RyanBilock/EMCH-308_Group-6_Final-Project/cad/concept_drawings/Hole_Layout_Stock1_Drilled_v2.png

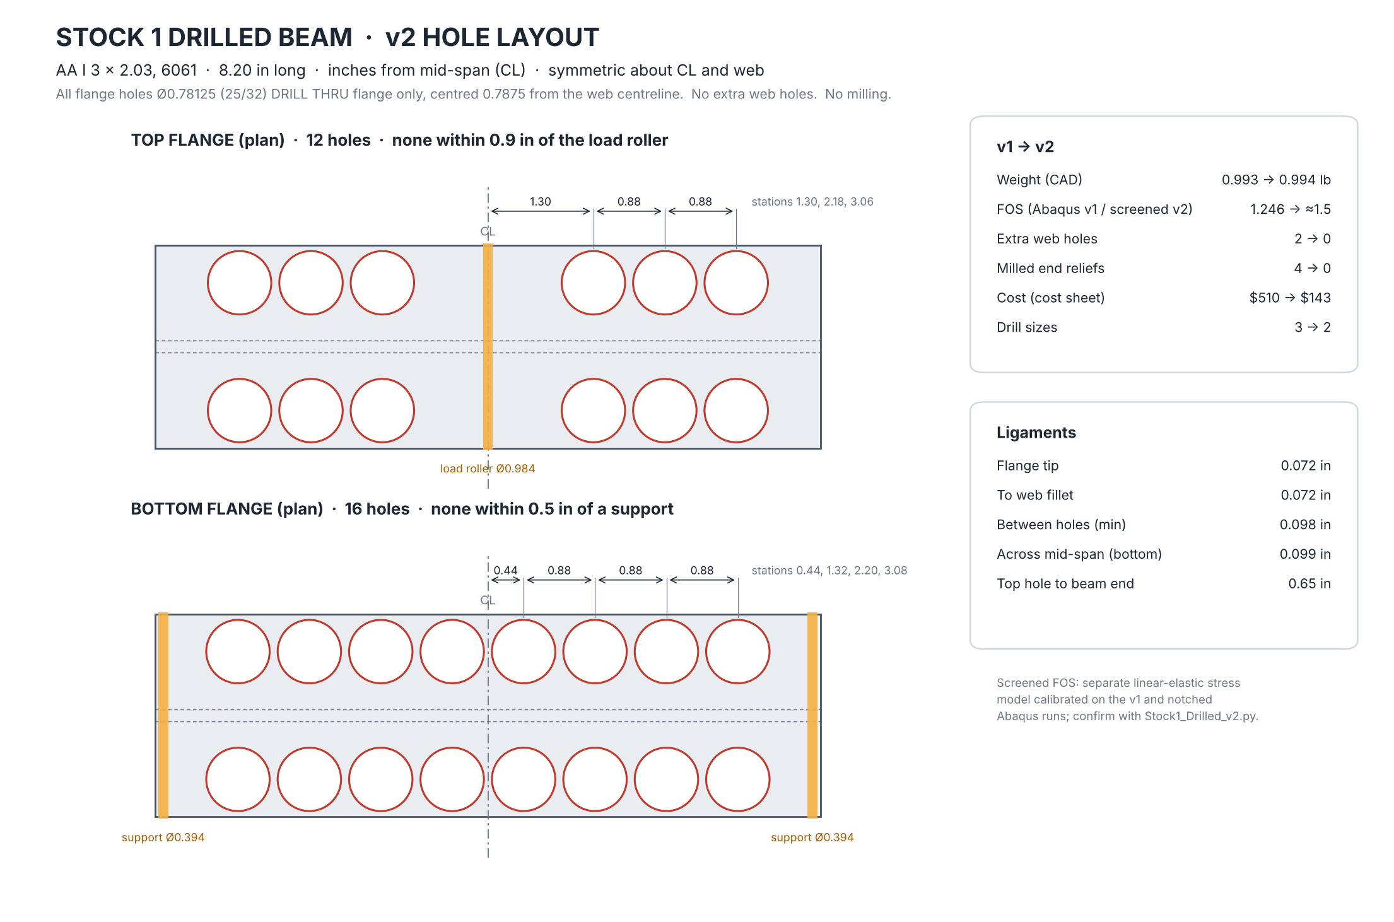
cad/concept_drawings/Hole_Layout_Stock1_Drilled_v2.png
