RyanBilock/EMCH-308_Group-6_Final-Project/cad/USC06_MTC06_IBeam_RevC_Drawing_sheet2.png

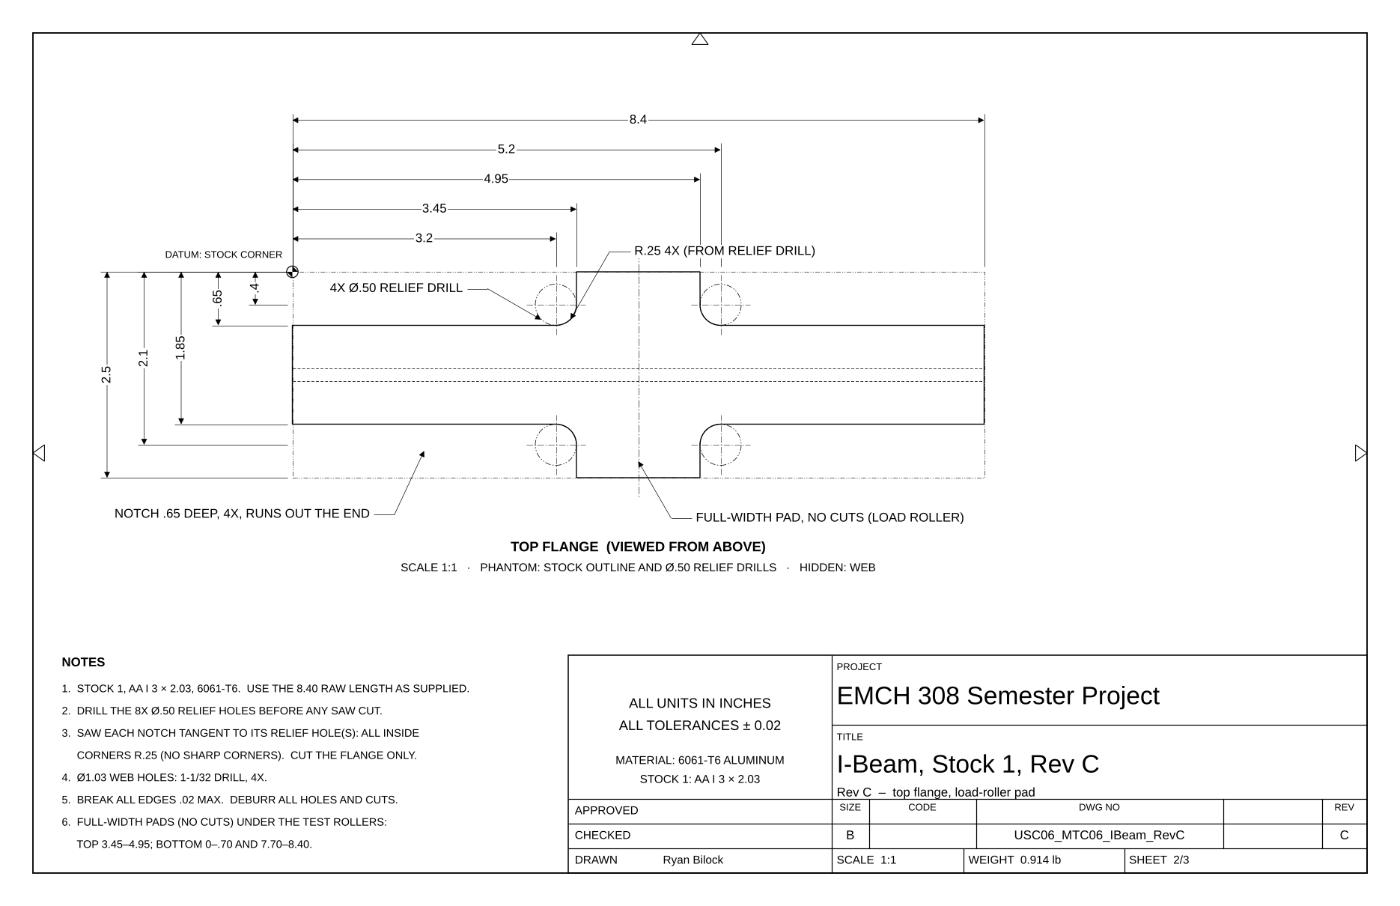
cad/USC06_MTC06_IBeam_RevC_Drawing_sheet2.png
