RyanBilock/EMCH-308_Group-6_Final-Project/Final_Design/Drawings/Design_Sheet_Stock1_Drilled_v2.png

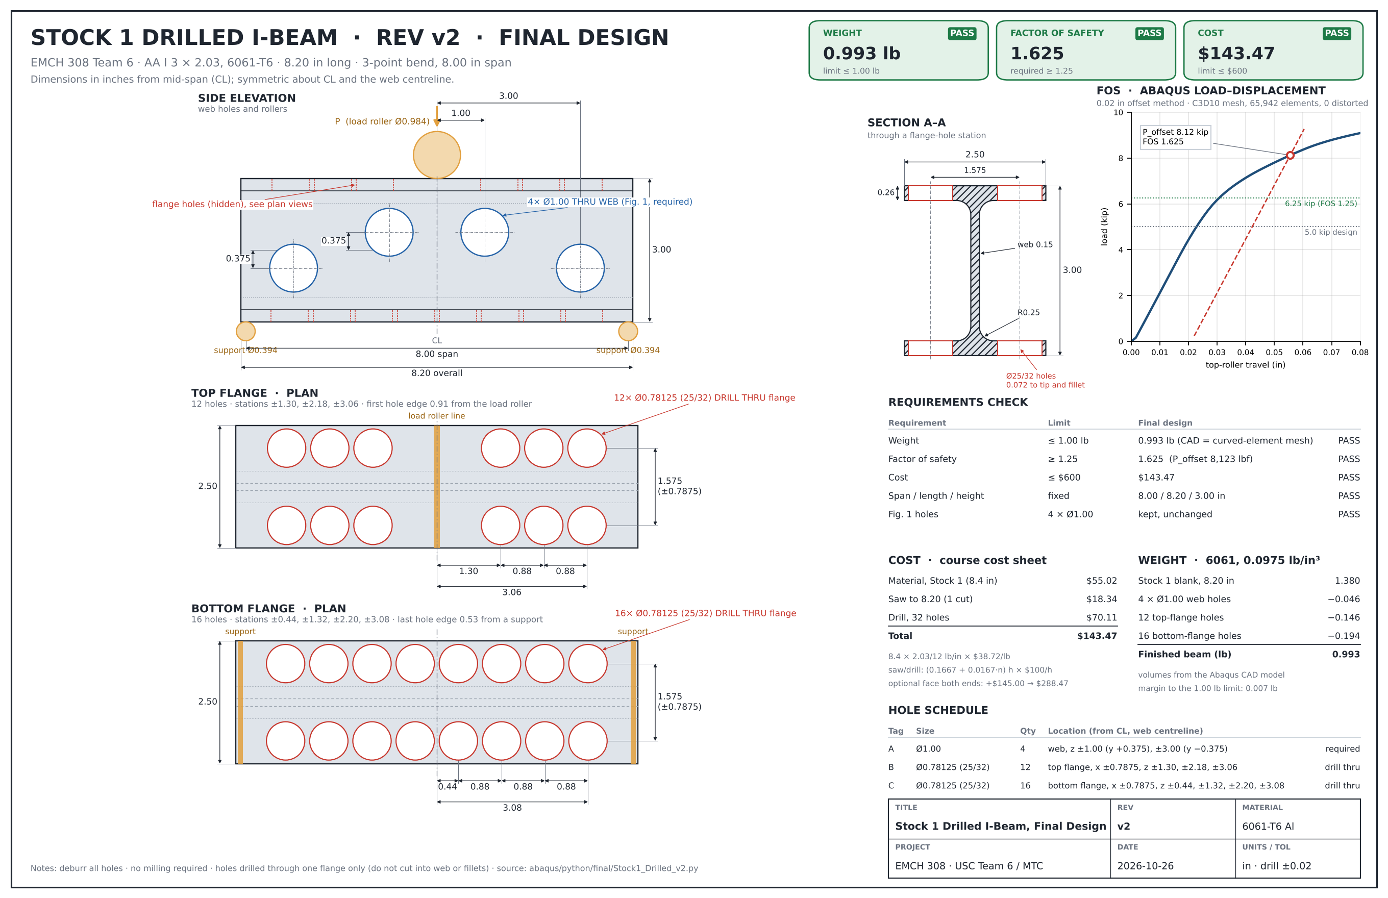
Final_Design/Drawings/Design_Sheet_Stock1_Drilled_v2.png
