RyanBilock/EMCH-308_Group-6_Final-Project/Final_Design/Drawings/Proposal_RevC_Stock1_v2.png

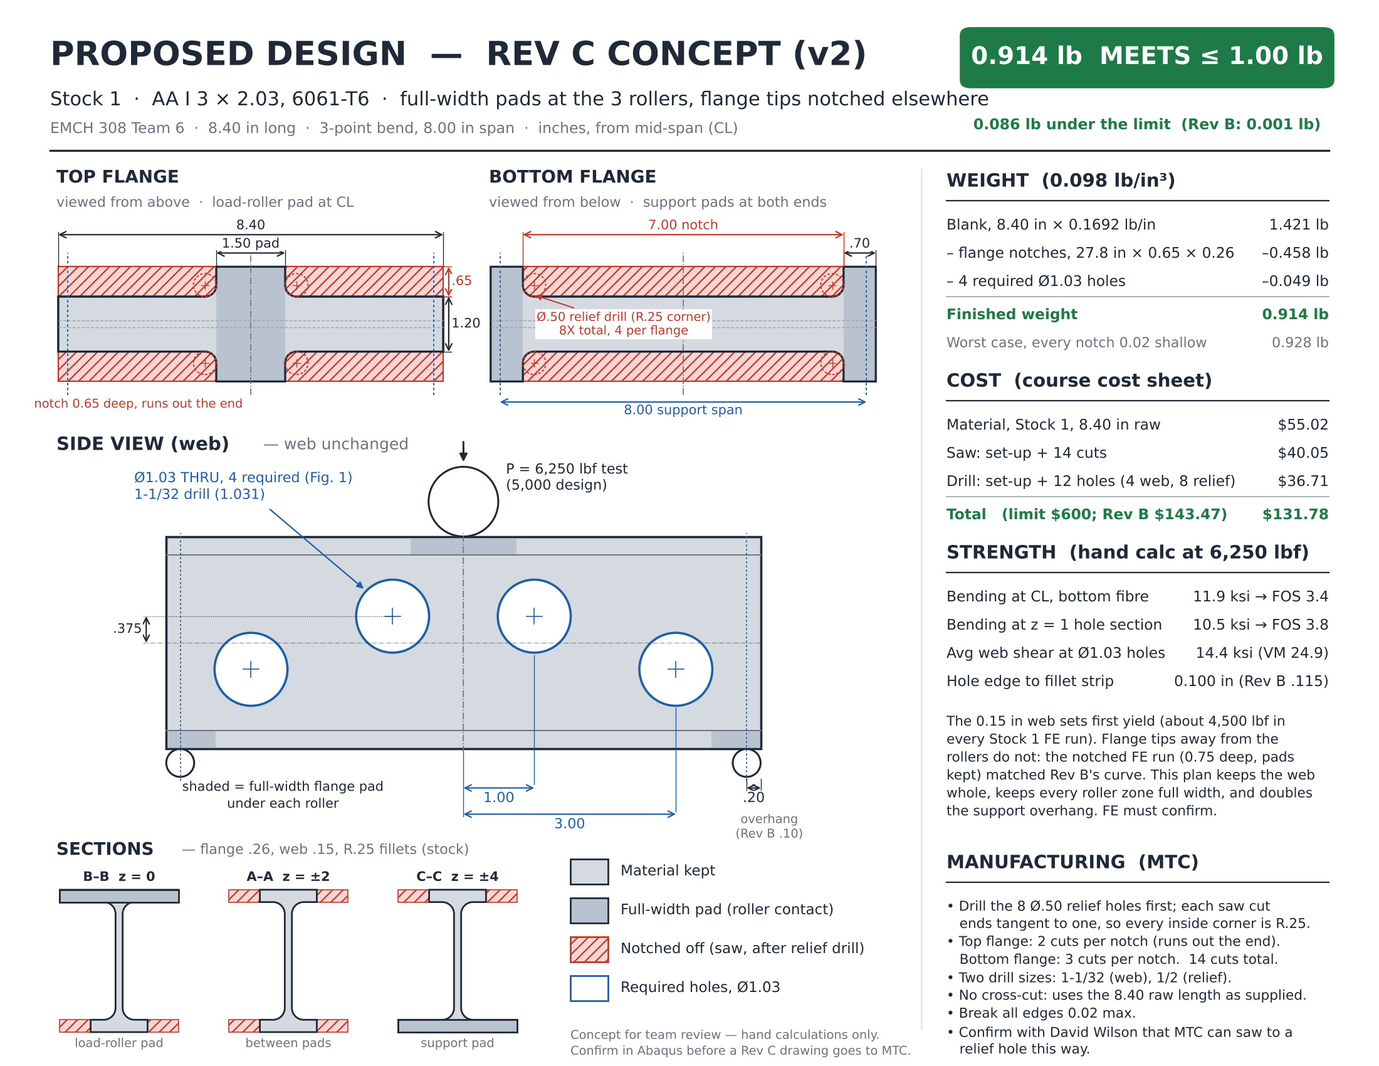
Final_Design/Drawings/Proposal_RevC_Stock1_v2.png
