RyanBilock/EMCH-308_Group-6_Final-Project/Final_Design/Drawings/USC06_MTC06_IBeam_RevC_Drawing_sheet1.png

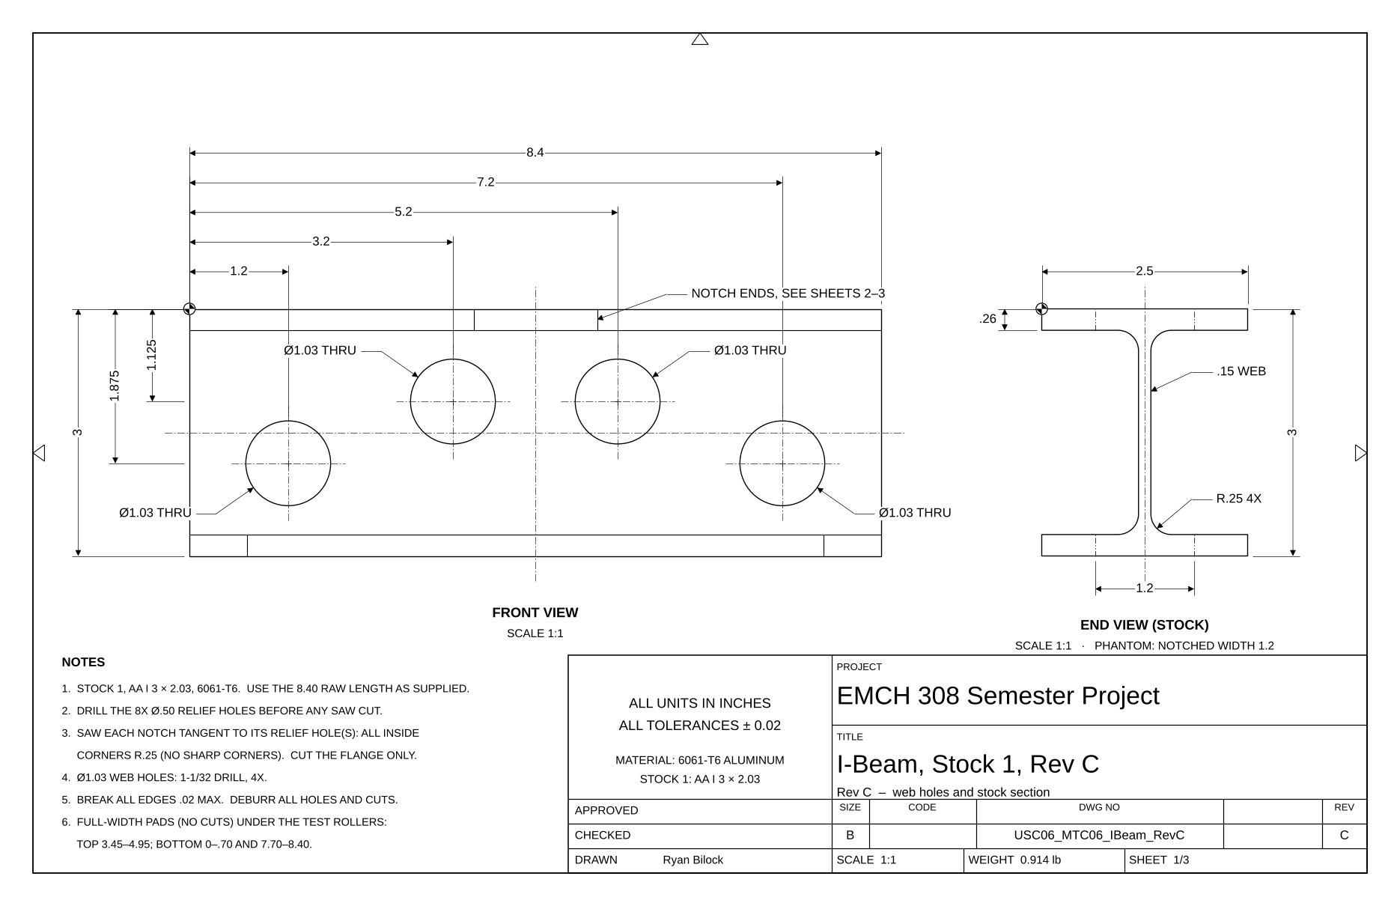
Final_Design/Drawings/USC06_MTC06_IBeam_RevC_Drawing_sheet1.png
