RyanBilock/EMCH-308_Group-6_Final-Project/results/final_design/Stock1_Drilled_v2_LoadDisp.png

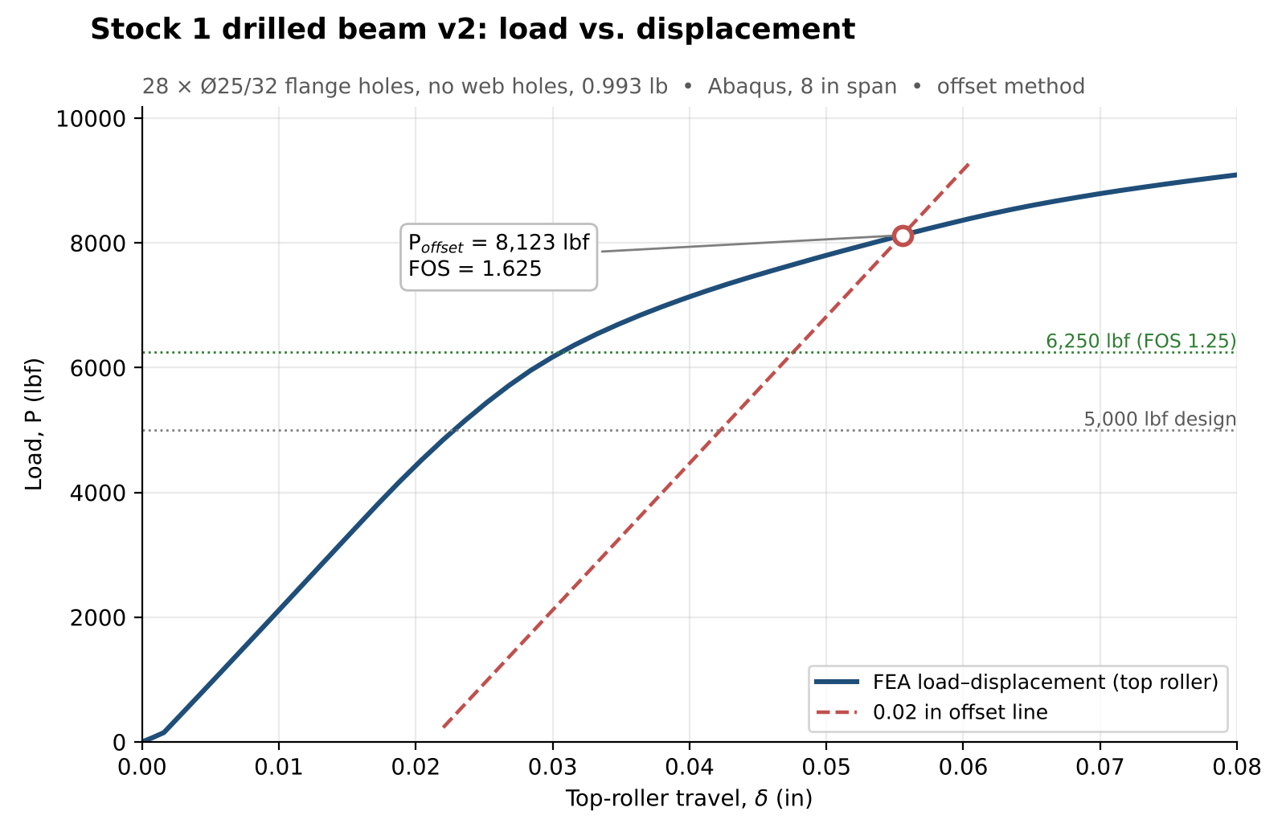
results/final_design/Stock1_Drilled_v2_LoadDisp.png
