RyanBilock/EMCH-308_Group-6_Final-Project/cost/ProjectCostSheet_RevC_Stock1_v2.xlsx

Sheet: Machining Cost
I-Beam Structure Analysis Project Cost
Stock Selection | Stock 1
Material Cost (per lb.) | $38.72
Raw Material Length (in) | 8.4
Weight (lb./in) | 0.1691666667
Material Cost Per Pc. | $55.02
Work Center Cost Including Overhead |  | Saw Cut | Saw Cut Miter | Drill | Face Ends | Mill
Tolerance (+/- inches) |  | 0.02 | 0.02 | 0.02 | 0.005 | 0.005
(2 x Labor + Material + Overhead) |  | $100.00 | $100.00 | $100.00 | $250.00 | $250.00
Set Up Time |  | 0.1667 | 0.1667 | 0.1667 | 0.5 | 0.5
Cycle Time Per Feature |  | 0.2338 | 0 | 0.2004 | 0 | 0
Cycle Time Basis |  | Per cut | Per cut | Per hole | Per end | Per inch of tool path with 0.05" removed for each pass
Qty Features |  | 14 | 0 | 12 | 0 | 0
Qty Parts |  | 1 | 1 | 1 | 1 | 1
Machine Time Cost |  | $40.05 | $0.00 | $36.71 | $0.00 | $0.00
Work Center Cost + Overhead + Machine Time | $131.78

Sheet: Stock Info
 | Stock 1 (https://www.onlinemetals.com/en/buy/aluminum/3-x-2-5-x-0-15-aluminum-i-beam-6061-t6-extruded-aluminum-association/pid/13207) | Stock 2 (https://www.onlinemetals.com/en/buy/aluminum/3-x-2-33-x-0-17-aluminum-i-beam-6061-t6-extruded-american-standard/pid/13216) | Stock 3 (https://www.onlinemetals.com/en/buy/aluminum/3-x-2-509-x-0-349-aluminum-i-beam-6061-t6-extruded-american-standard/pid/13217)
Height (in) | 3 | 3 | 3
Flange Width (in) | 2.5 | 2.33 | 2.509
Flange Thickness (in) | 0.26 | 0.17 | 0.17
Web Thickness (in) | 0.15 | 0.17 | 0.349
Material Cost (per lb.) | $38.72 | $26.78 | $39.36
Raw Material Length (in) | 8.4 | 8.4 | 8.4
Weight (lb./in) | 0.1691666667 | 0.1641666667 | 0.2166666667
Material Cost Per Pc. | $55.02 | $36.93 | $71.64
