RyanBilock/EMCH-308_Group-6_Final-Project/cad/concept_drawings/Cost_Plan_Stock1_v2.png

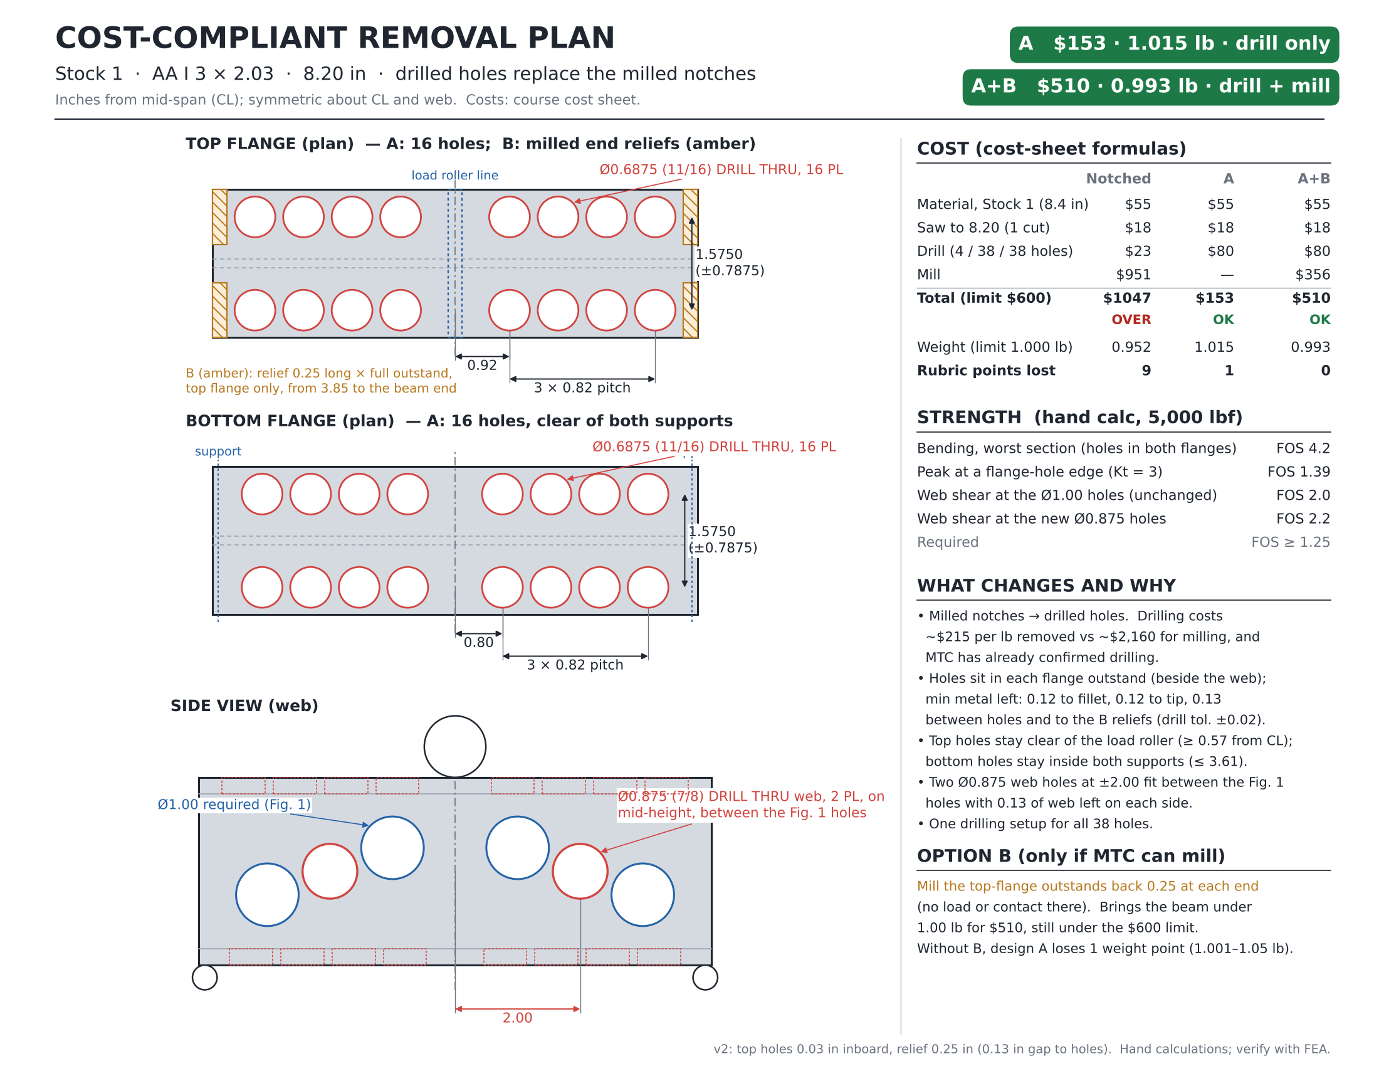
cad/concept_drawings/Cost_Plan_Stock1_v2.png
