RyanBilock/EMCH-308_Group-6_Final-Project/cad/concept_drawings/Material_Removal_Stock1_v1.png

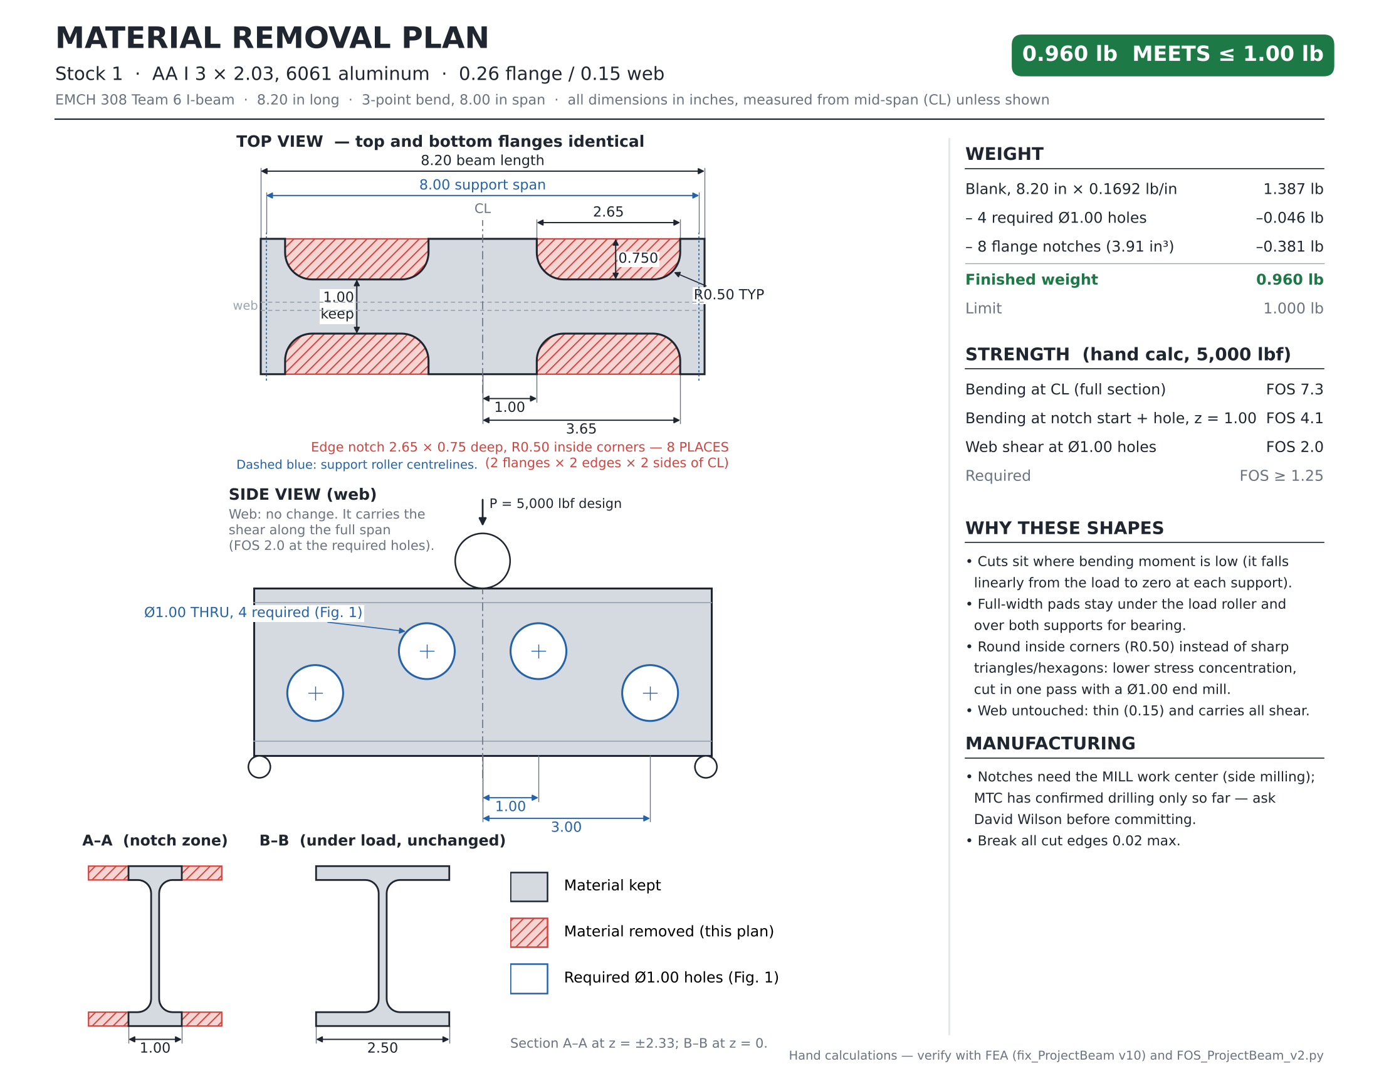
cad/concept_drawings/Material_Removal_Stock1_v1.png
