RyanBilock/EMCH-308_Group-6_Final-Project/cad/USC06_MTC06_IBeam_RevB.step

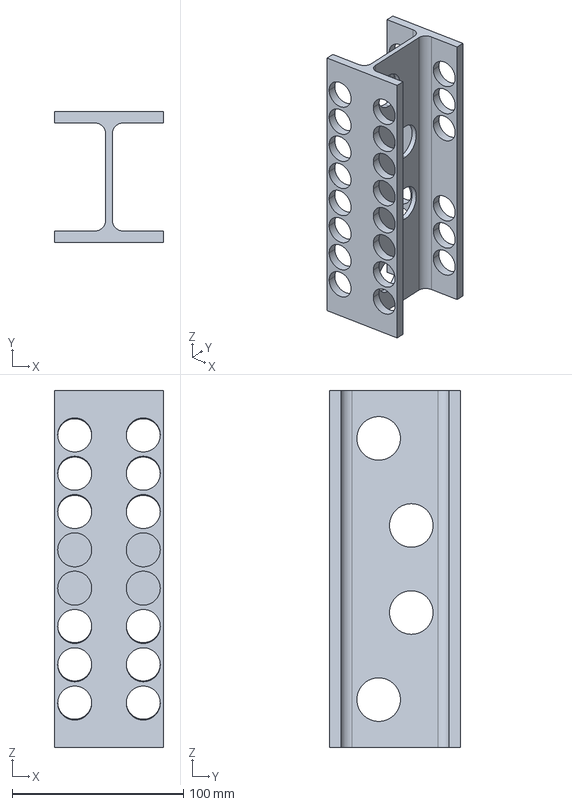
[picture p20: CAD file, 2026-10-26]
cad/USC06_MTC06_IBeam_RevB.step
63.5 x 76.2 x 208.3 mm
