RyanBilock/EMCH-308_Group-6_Final-Project/Final_Design/CAD/USC06_MTC06_IBeam_RevC.step

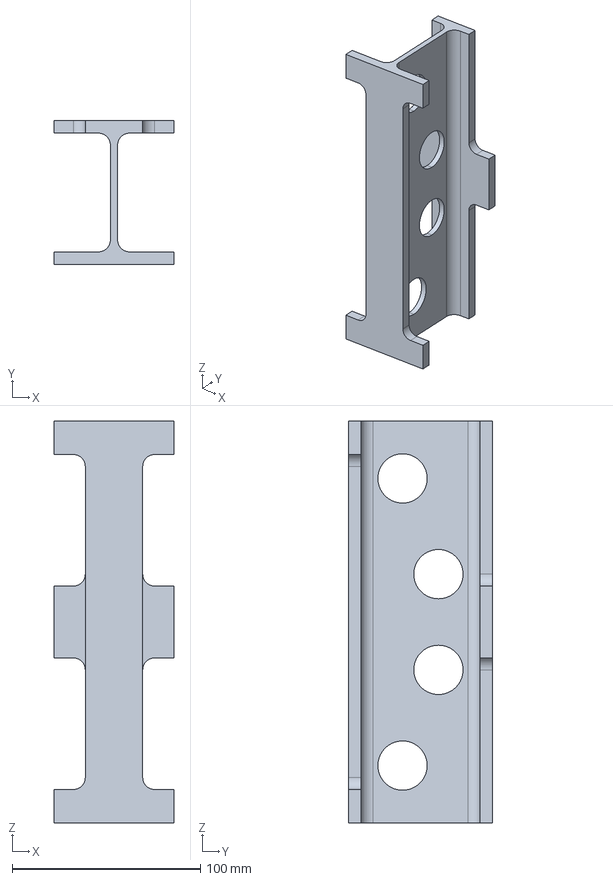
[picture p21: CAD file, 2026-11-03]
Final_Design/CAD/USC06_MTC06_IBeam_RevC.step
63.5 x 76.2 x 213.4 mm
