RyanBilock/EMCH-308_Group-6_Final-Project/Final_Design/Results/FOS_Stock1_RevC_v2_LoadDisp.csv

travel_in | load_lbf | offset_line_lbf
0.000000 | 0.00 | 0.00
0.000080 | 20.25 | 0.00
0.000160 | 40.42 | 0.00
0.000280 | 70.73 | 0.00
0.000460 | 116.19 | 0.00
0.000730 | 184.38 | 0.00
0.001135 | 286.66 | 0.00
0.001742 | 440.05 | 0.00
0.002542 | 642.00 | 0.00
0.003342 | 843.91 | 0.00
0.004142 | 1045.77 | 0.00
0.004943 | 1247.59 | 0.00
0.005743 | 1449.35 | 0.00
0.006543 | 1651.07 | 0.00
0.007343 | 1852.75 | 0.00
0.008143 | 2054.37 | 0.00
0.008942 | 2255.95 | 0.00
0.009743 | 2457.49 | 0.00
0.010542 | 2658.92 | 0.00
0.011343 | 2860.16 | 0.00
0.012142 | 3061.18 | 0.00
0.012943 | 3261.92 | 0.00
0.013742 | 3462.22 | 0.00
0.014542 | 3662.04 | 0.00
0.015343 | 3861.46 | 0.00
0.016143 | 4060.37 | 0.00
0.016942 | 4258.71 | 0.00
0.017742 | 4456.40 | 0.00
0.018543 | 4652.99 | 0.00
0.019343 | 4847.56 | 0.00
0.020142 | 5039.25 | 46.59
0.020942 | 5227.46 | 247.40
0.021743 | 5411.50 | 448.20
0.022543 | 5590.75 | 649.01
0.023342 | 5763.84 | 849.81
0.024143 | 5929.62 | 1050.62
0.024943 | 6088.64 | 1251.42
0.025742 | 6240.76 | 1452.23
0.026542 | 6385.97 | 1653.03
0.027343 | 6524.51 | 1853.84
0.028143 | 6656.54 | 2054.64
0.028942 | 6781.22 | 2255.45
0.029742 | 6897.63 | 2456.25
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
