RyanBilock/EMCH-308_Group-6_Final-Project/results/iterations/Stock1_Drilled_v1/FOS_Stock1_Drilled_LoadDisp.csv

travel_in | load_lbf | offset_line_lbf
0.000000 | 0.00 | 0.00
0.000800 | 69.04 | 0.00
0.001600 | 80.63 | 0.00
0.002800 | 295.82 | 0.00
0.004400 | 594.12 | 0.00
0.006000 | 892.87 | 0.00
0.007600 | 1191.99 | 0.00
0.008000 | 1266.80 | 0.00
0.009600 | 1566.08 | 0.00
0.011200 | 1865.37 | 0.00
0.012800 | 2164.34 | 0.00
0.014400 | 2459.85 | 0.00
0.016000 | 2749.47 | 0.00
0.017600 | 3032.59 | 0.00
0.019200 | 3305.53 | 0.00
0.020800 | 3564.99 | 0.00
0.022400 | 3807.80 | 236.35
0.024000 | 4035.71 | 531.85
0.025600 | 4248.83 | 827.35
0.027200 | 4446.92 | 1122.85
0.028800 | 4633.32 | 1418.35
0.030400 | 4804.77 | 1713.86
0.032000 | 4959.61 | 2009.36
0.033600 | 5094.03 | 2304.86
0.035200 | 5213.50 | 2600.36
0.036800 | 5323.12 | 2895.86
0.038400 | 5424.83 | 3191.36
0.040000 | 5519.65 | 3486.86
0.041600 | 5609.60 | 3782.37
0.043200 | 5695.22 | 4077.87
0.044800 | 5777.39 | 4373.37
0.046400 | 5856.28 | 4668.87
0.048000 | 5931.88 | 4964.37
0.049600 | 6004.62 | 5259.87
0.051200 | 6075.54 | 5555.37
0.052800 | 6144.28 | 5850.87
0.054400 | 6210.60 | 6146.38
0.056000 | 6274.24 | 6441.88
0.057600 | 6335.16 | 6737.38
0.059200 | 6393.19 | 7032.88
0.060800 | 6448.49 | 7328.38
0.062400 | 6501.18 | 7623.88
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
