RyanBilock/EMCH-308_Group-6_Final-Project/results/iterations/Stock1_Drilled_v2_RevB/FOS_Stock1_Drilled_v2_LoadDisp.csv

travel_in | load_lbf | offset_line_lbf
0.000000 | 0.00 | 0.00
0.000800 | 71.66 | 0.00
0.001600 | 150.85 | 0.00
0.002800 | 428.26 | 0.00
0.004400 | 799.98 | 0.00
0.006000 | 1173.66 | 0.00
0.007600 | 1548.60 | 0.00
0.009200 | 1923.92 | 0.00
0.010800 | 2300.29 | 0.00
0.012400 | 2677.65 | 0.00
0.014000 | 3054.87 | 0.00
0.015600 | 3431.64 | 0.00
0.017200 | 3805.70 | 0.00
0.018800 | 4168.63 | 0.00
0.020400 | 4514.75 | 0.00
0.022000 | 4843.64 | 230.43
0.023600 | 5152.60 | 606.91
0.025200 | 5443.18 | 983.38
0.026800 | 5712.41 | 1359.86
0.028400 | 5956.57 | 1736.33
0.030000 | 6171.03 | 2112.81
0.031600 | 6363.15 | 2489.29
0.033200 | 6536.71 | 2865.76
0.034800 | 6694.88 | 3242.24
0.036400 | 6841.32 | 3618.72
0.038000 | 6977.64 | 3995.19
0.039600 | 7105.77 | 4371.67
0.041200 | 7227.05 | 4748.14
0.042800 | 7341.38 | 5124.62
0.044400 | 7449.59 | 5501.10
0.046000 | 7553.01 | 5877.57
0.047600 | 7653.05 | 6254.05
0.049200 | 7752.89 | 6630.52
0.050800 | 7848.87 | 7007.00
0.052400 | 7942.31 | 7383.48
0.054000 | 8035.46 | 7759.95
0.055600 | 8125.94 | 8136.43
0.057200 | 8215.09 | 8512.91
0.058800 | 8301.24 | 8889.38
0.060400 | 8385.25 | 9265.86
0.062000 | 8464.84 | 9642.34
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
