RyanBilock/EMCH-308_Group-6_Final-Project/results/iterations/Stock1_Notched/FOS_Stock1_Notched_LoadDisp.csv

travel_in | load_lbf | offset_line_lbf
0.000000 | 0.00 | 0.00
0.000800 | 76.42 | 0.00
0.001600 | 125.12 | 0.00
0.002800 | 411.25 | 0.00
0.004400 | 793.81 | 0.00
0.006000 | 1178.60 | 0.00
0.007600 | 1563.94 | 0.00
0.008000 | 1660.25 | 0.00
0.009600 | 2045.41 | 0.00
0.011200 | 2433.99 | 0.00
0.012800 | 2823.50 | 0.00
0.014400 | 3212.85 | 0.00
0.016000 | 3600.93 | 0.00
0.017600 | 3981.21 | 0.00
0.019200 | 4344.70 | 0.00
0.020800 | 4689.81 | 0.00
0.022400 | 5014.37 | 303.81
0.024000 | 5318.54 | 691.33
0.025600 | 5600.56 | 1078.85
0.027200 | 5859.12 | 1466.37
0.028800 | 6087.37 | 1853.89
0.030400 | 6289.77 | 2241.41
0.032000 | 6472.69 | 2628.93
0.033600 | 6640.61 | 3016.45
0.035200 | 6796.51 | 3403.97
0.036800 | 6942.87 | 3791.49
0.038400 | 7079.98 | 4179.01
0.040000 | 7210.35 | 4566.53
0.041600 | 7332.60 | 4954.05
0.043200 | 7448.16 | 5341.57
0.044800 | 7558.24 | 5729.09
0.046400 | 7663.22 | 6116.61
0.048000 | 7765.93 | 6504.13
0.049600 | 7867.85 | 6891.65
0.051200 | 7967.88 | 7279.16
0.052800 | 8064.11 | 7666.68
0.054400 | 8156.21 | 8054.20
0.056000 | 8243.89 | 8441.72
0.057600 | 8327.03 | 8829.24
0.059200 | 8405.61 | 9216.76
0.060800 | 8479.76 | 9604.28
0.062400 | 8549.66 | 9991.80
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
