RyanBilock/EMCH-308_Group-6_Final-Project/results/iterations/Stock3_Beam_8p2in/FOS_Beam_8p2in_LoadDisp.csv

travel_in | load_lbf | offset_line_lbf
0.000000 | 0.00 | 0.00
0.000800 | 64.93 | 0.00
0.001600 | 267.42 | 0.00
0.002800 | 867.28 | 0.00
0.004400 | 1668.01 | 0.00
0.006000 | 2468.47 | 0.00
0.007600 | 3268.54 | 0.00
0.008000 | 3468.51 | 0.00
0.009600 | 4267.64 | 0.00
0.011200 | 5062.99 | 0.00
0.012800 | 5851.75 | 0.00
0.014400 | 6630.63 | 0.00
0.016000 | 7395.99 | 0.00
0.017600 | 8144.78 | 0.00
0.019200 | 8870.98 | 0.00
0.020800 | 9571.75 | 0.00
0.022400 | 10237.42 | 774.91
0.024000 | 10860.59 | 1551.07
0.025600 | 11443.54 | 2327.23
0.027200 | 11989.61 | 3103.40
0.028800 | 12498.66 | 3879.56
0.030400 | 12974.12 | 4655.72
0.032000 | 13414.18 | 5431.89
0.033600 | 13817.96 | 6208.05
0.035200 | 14185.69 | 6984.21
0.036800 | 14532.67 | 7760.37
0.038400 | 14874.16 | 8536.53
0.040000 | 15194.29 | 9312.70
0.041600 | 15492.78 | 10088.86
0.043200 | 15772.56 | 10865.02
0.044800 | 16035.45 | 11641.18
0.046400 | 16283.44 | 12417.34
0.048000 | 16517.99 | 13193.51
0.049600 | 16740.02 | 13969.67
0.051200 | 16951.69 | 14745.83
0.052800 | 17154.50 | 15521.99
0.054400 | 17357.89 | 16298.16
0.056000 | 17556.84 | 17074.32
0.057600 | 17759.27 | 17850.48
0.059200 | 17952.45 | 18626.64
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
