RyanBilock/EMCH-308_Group-6_Final-Project/results/iterations/Stock1_Drilled_v1/Stock1_Drilled_LoadDisp.png

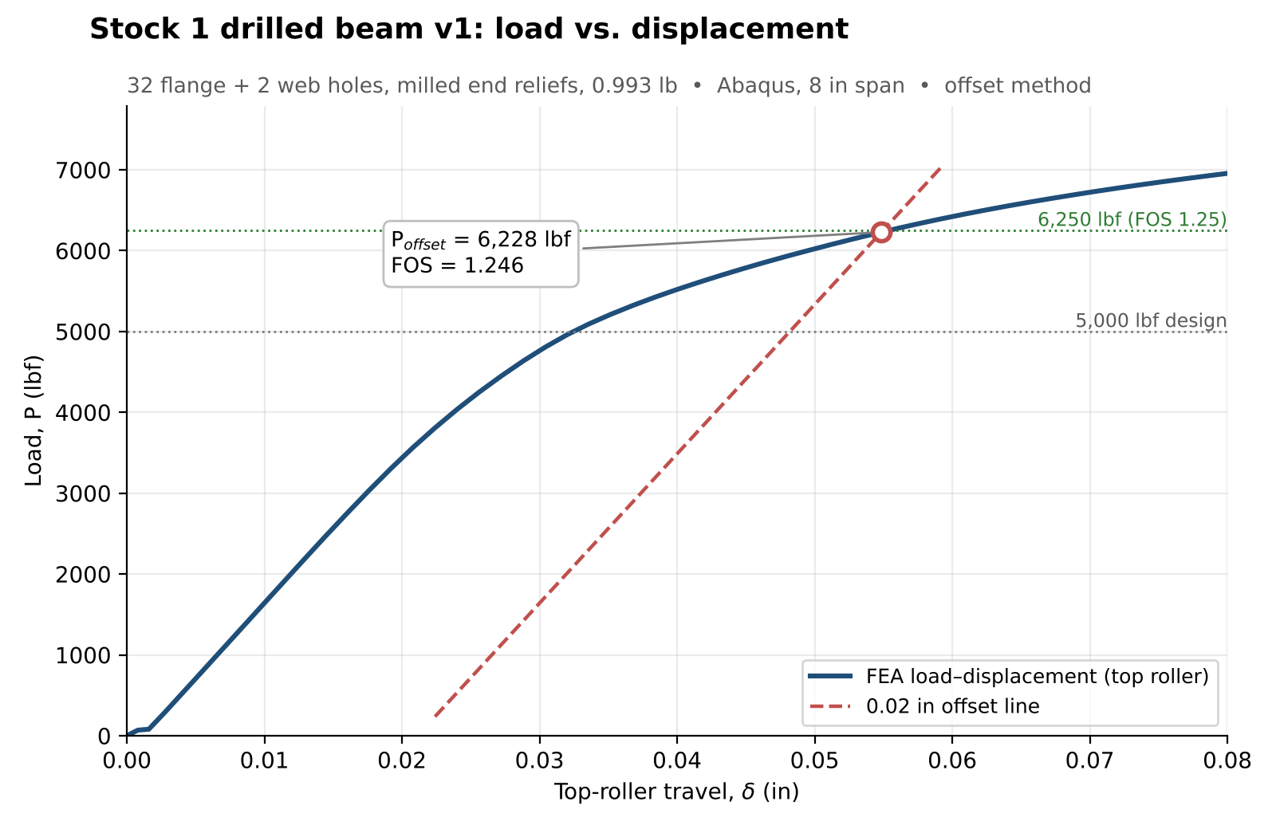
results/iterations/Stock1_Drilled_v1/Stock1_Drilled_LoadDisp.png
