RyanBilock/EMCH-308_Group-6_Final-Project/results/iterations/Stock3_Beam_8p2in/Stock3_Beam_8p2in_LoadDisp.png

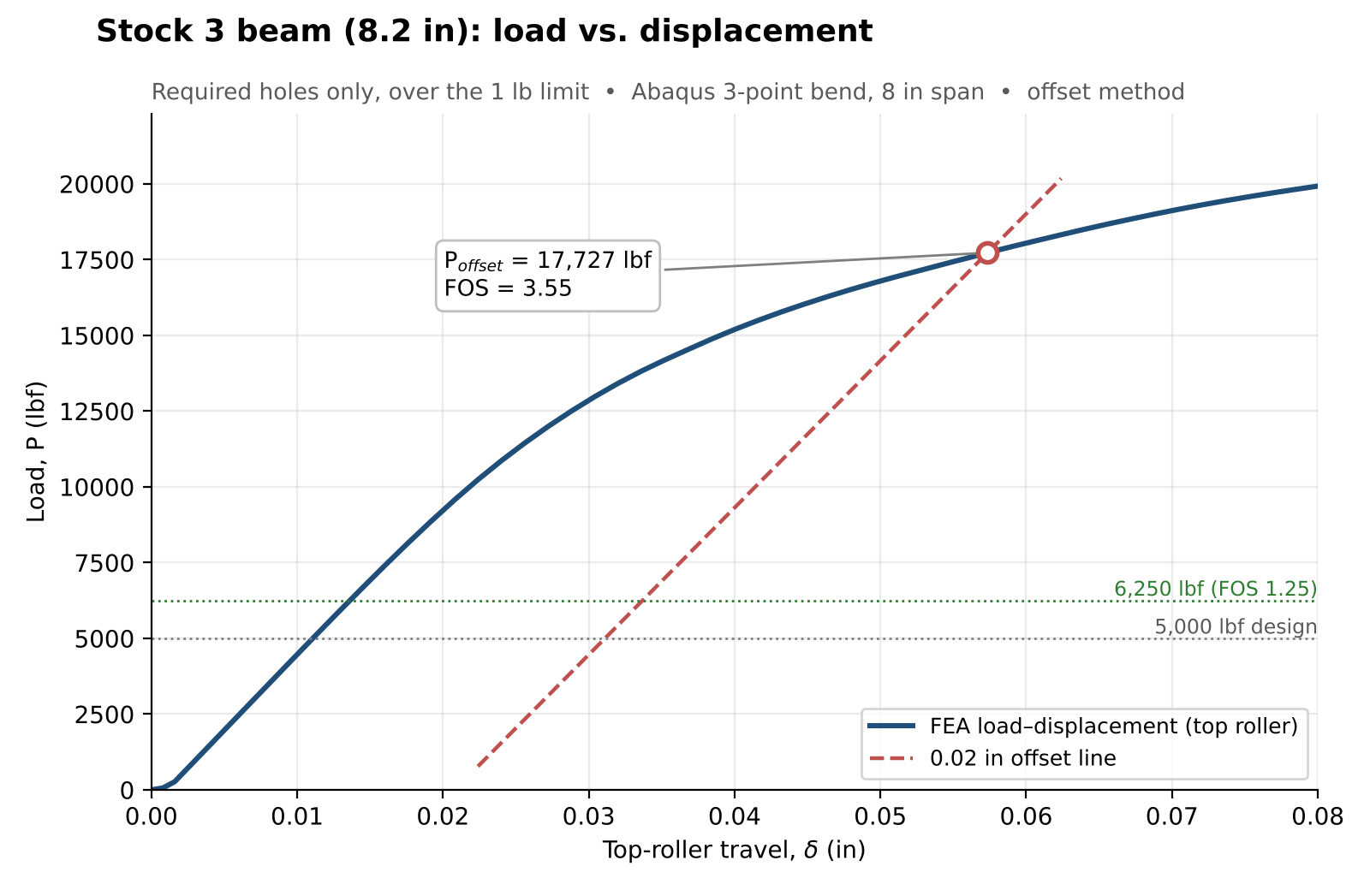
results/iterations/Stock3_Beam_8p2in/Stock3_Beam_8p2in_LoadDisp.png
