RyanBilock/EMCH-308_Group-6_Final-Project/results/Stock1_Drilled/Stock1_Drilled_LoadDisp.png

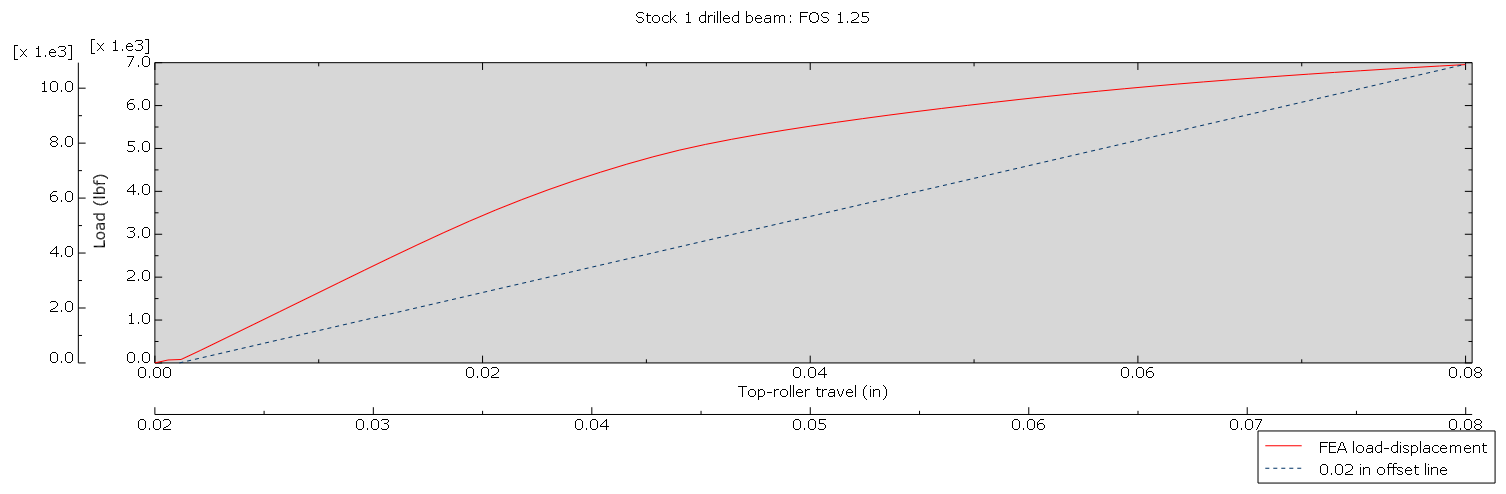
results/Stock1_Drilled/Stock1_Drilled_LoadDisp.png
