RyanBilock/EMCH-308_Group-6_Final-Project/results/Stock1_Notched/Stock1_Notched_LoadDisp.png

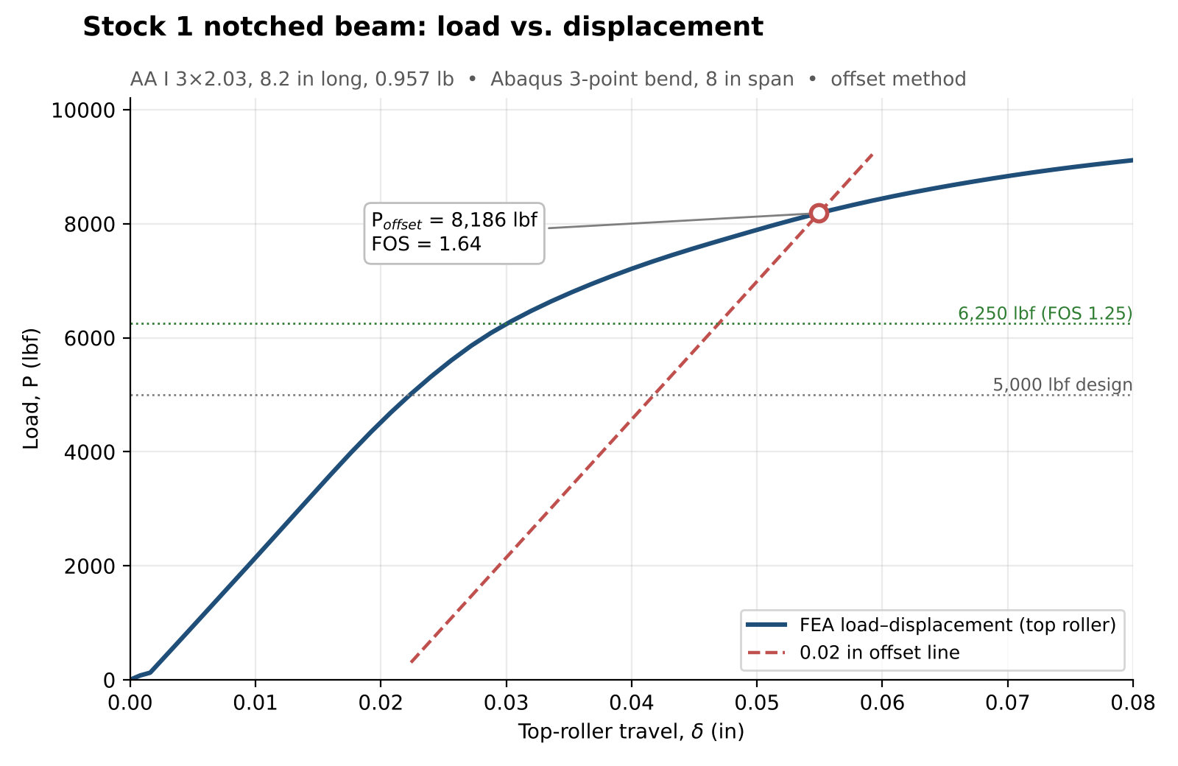
results/Stock1_Notched/Stock1_Notched_LoadDisp.png
