RyanBilock/EMCH-308_Group-6_Final-Project/cad/USC06_MTC06_IBeam_RevC_Drawing.pdf

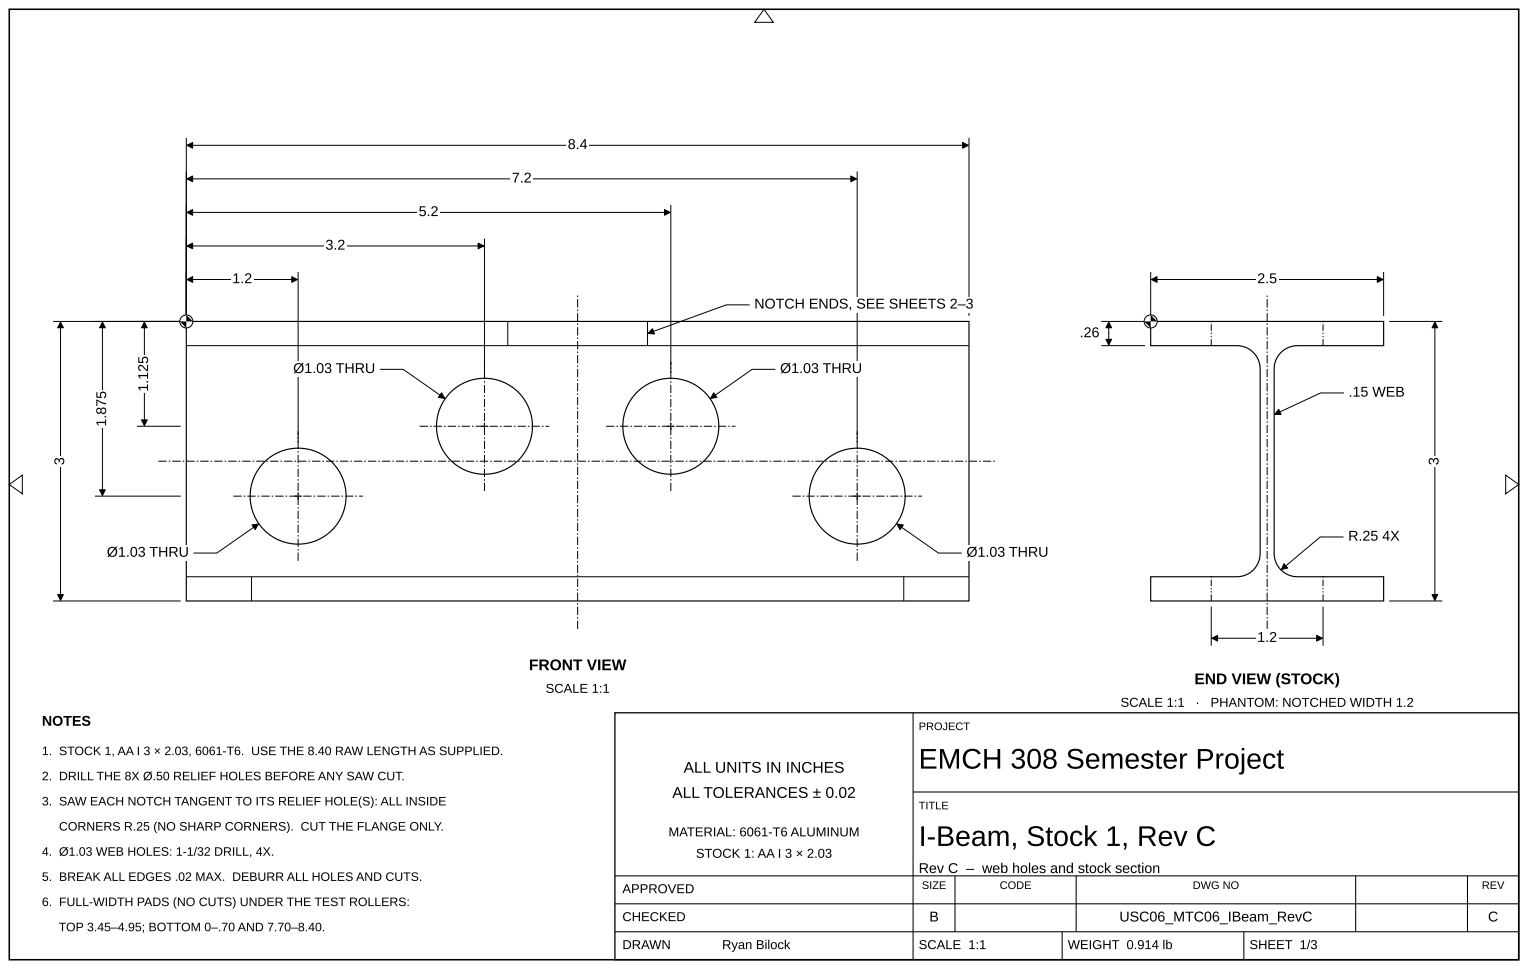
[picture p26: page 1]
Ø1.03 THRU; NOTCH ENDS,; SEE SHEETS 2–3; FRONT VIEW; SCALE 1:1; .15 WEB; NOTES; MATERIAL: 6061-T6 ALUMINUM; STOCK 1: AA I 3 × 2.03; APPROVED; CHECKED; DRAWN; Ryan Bilock; SIZE; CODE; DWG NO; USC06_MTC06_IBeam_RevC; REV; WEIGHT 0.914 lb; SHEET 1/3

END VIEW (STOCK)

SCALE 1:1 · PHANTOM: NOTCHED WIDTH 1.2

PROJECT
EMCH 308 Semester Project

1. STOCK 1, AA I 3 × 2.03, 6061-T6. USE THE 8.40 RAW LENGTH AS SUPPLIED.

ALL UNITS IN INCHES
ALL TOLERANCES ± 0.02

2. DRILL THE 8X Ø.50 RELIEF HOLES BEFORE ANY SAW CUT.

3. SAW EACH NOTCH TANGENT TO ITS RELIEF HOLE(S): ALL INSIDE

TITLE
I-Beam, Stock 1, Rev C

CORNERS R.25 (NO SHARP CORNERS). CUT THE FLANGE ONLY.

4. Ø1.03 WEB HOLES: 1-1/32 DRILL, 4X.

Rev C – web holes and stock section

5. BREAK ALL EDGES .02 MAX. DEBURR ALL HOLES AND CUTS.

6. FULL-WIDTH PADS (NO CUTS) UNDER THE TEST ROLLERS:

TOP 3.45–4.95; BOTTOM 0–.70 AND 7.70–8.40.

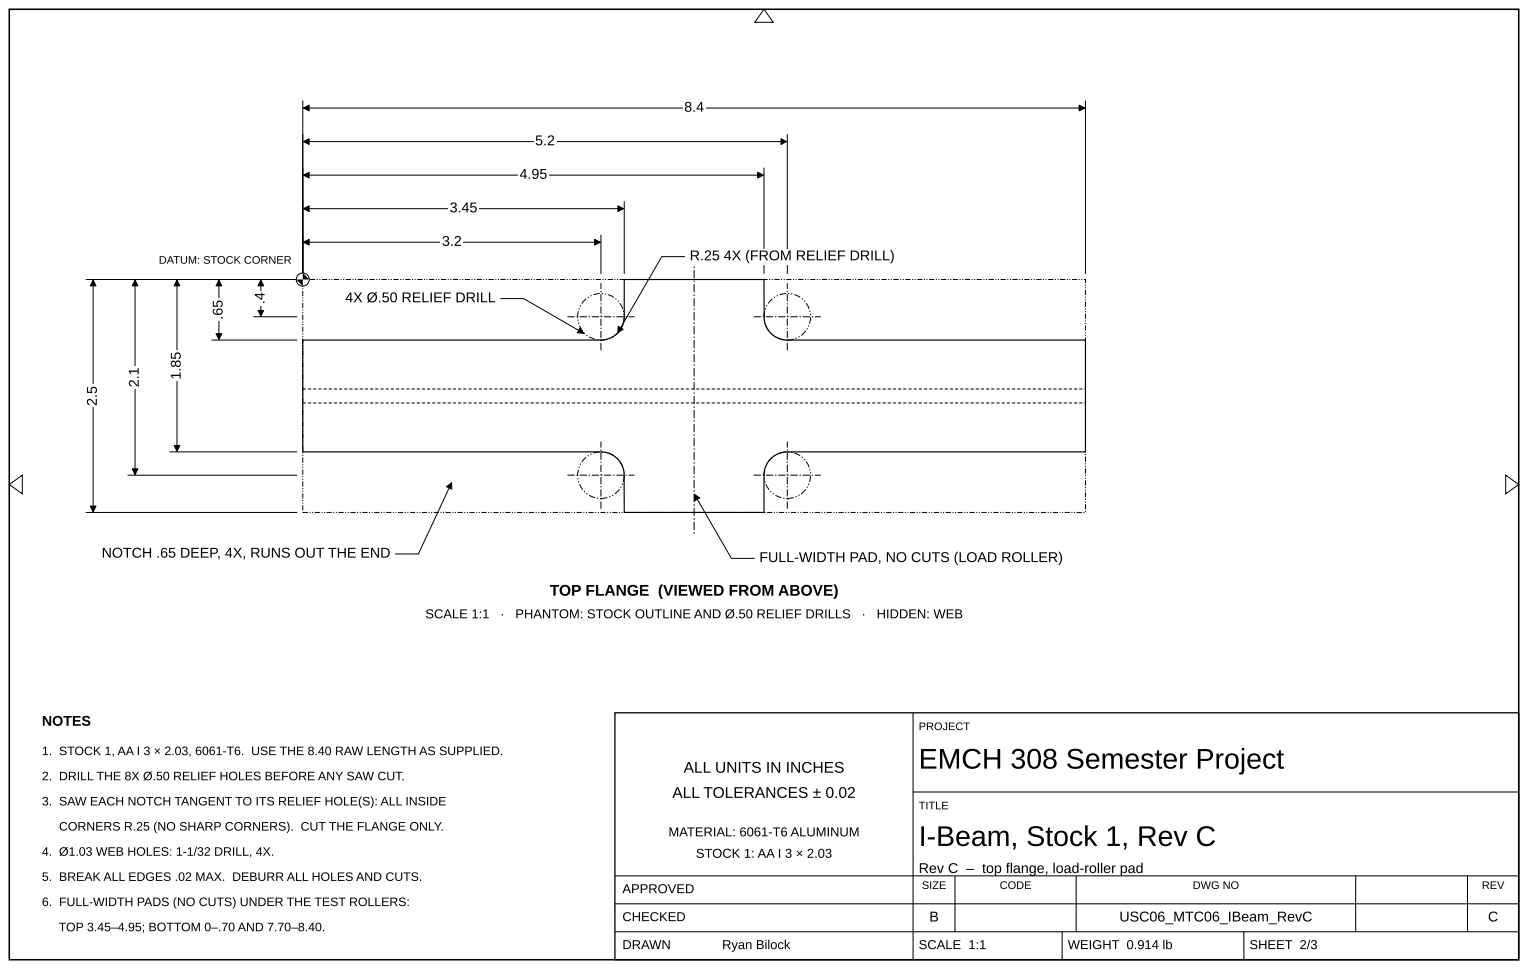
[picture p27: page 2]
4X Ø.50 RELIEF DRILL; NOTCH .65 DEEP, 4X, RUNS OUT THE END; FULL-WIDTH PAD, NO CUTS (LOAD ROLLER); NOTES; MATERIAL: 6061-T6 ALUMINUM; STOCK 1: AA I 3 × 2.03; APPROVED; SIZE; CODE; DWG NO; REV

DATUM: STOCK CORNER

R.25 4X (FROM RELIEF DRILL)

TOP FLANGE (VIEWED FROM ABOVE)

SCALE 1:1 · PHANTOM: STOCK OUTLINE AND Ø.50 RELIEF DRILLS · HIDDEN: WEB

PROJECT
EMCH 308 Semester Project

1. STOCK 1, AA I 3 × 2.03, 6061-T6. USE THE 8.40 RAW LENGTH AS SUPPLIED.

ALL UNITS IN INCHES
ALL TOLERANCES ± 0.02

2. DRILL THE 8X Ø.50 RELIEF HOLES BEFORE ANY SAW CUT.

3. SAW EACH NOTCH TANGENT TO ITS RELIEF HOLE(S): ALL INSIDE

TITLE
I-Beam, Stock 1, Rev C

CORNERS R.25 (NO SHARP CORNERS). CUT THE FLANGE ONLY.

4. Ø1.03 WEB HOLES: 1-1/32 DRILL, 4X.

Rev C – top flange, load-roller pad

5. BREAK ALL EDGES .02 MAX. DEBURR ALL HOLES AND CUTS.

6. FULL-WIDTH PADS (NO CUTS) UNDER THE TEST ROLLERS:

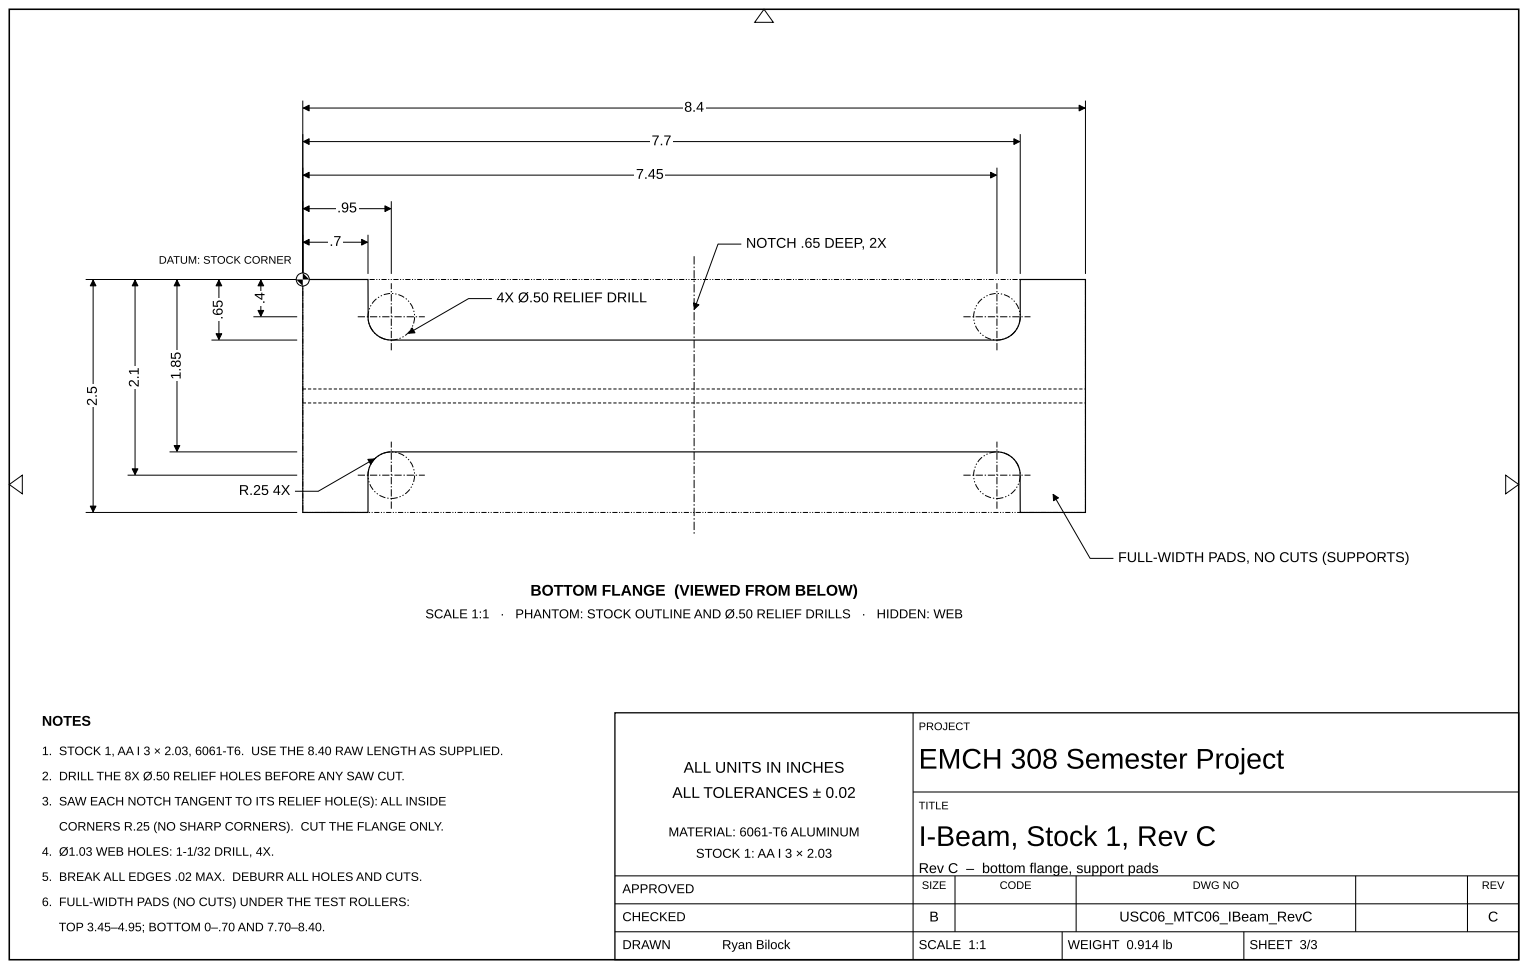
[picture p28: page 3]
4X Ø.50 RELIEF DRILL; NOTCH .65 DEEP, 2X; NOTES; MATERIAL: 6061-T6 ALUMINUM; STOCK 1: AA I 3 × 2.03; APPROVED; SIZE; CODE; DWG NO; REV

DATUM: STOCK CORNER

FULL-WIDTH PADS, NO CUTS (SUPPORTS)

BOTTOM FLANGE (VIEWED FROM BELOW)

SCALE 1:1 · PHANTOM: STOCK OUTLINE AND Ø.50 RELIEF DRILLS · HIDDEN: WEB

PROJECT
EMCH 308 Semester Project

1. STOCK 1, AA I 3 × 2.03, 6061-T6. USE THE 8.40 RAW LENGTH AS SUPPLIED.

ALL UNITS IN INCHES
ALL TOLERANCES ± 0.02

2. DRILL THE 8X Ø.50 RELIEF HOLES BEFORE ANY SAW CUT.

3. SAW EACH NOTCH TANGENT TO ITS RELIEF HOLE(S): ALL INSIDE

TITLE
I-Beam, Stock 1, Rev C

CORNERS R.25 (NO SHARP CORNERS). CUT THE FLANGE ONLY.

4. Ø1.03 WEB HOLES: 1-1/32 DRILL, 4X.

Rev C – bottom flange, support pads

5. BREAK ALL EDGES .02 MAX. DEBURR ALL HOLES AND CUTS.

6. FULL-WIDTH PADS (NO CUTS) UNDER THE TEST ROLLERS:
