RyanBilock/EMCH-308_Group-6_Final-Project/cad/old_designs/RevB/drawings/Design_Sheet_Stock1_Drilled_v2.pdf

### SIDE ELEVATION

### SECTION A–A

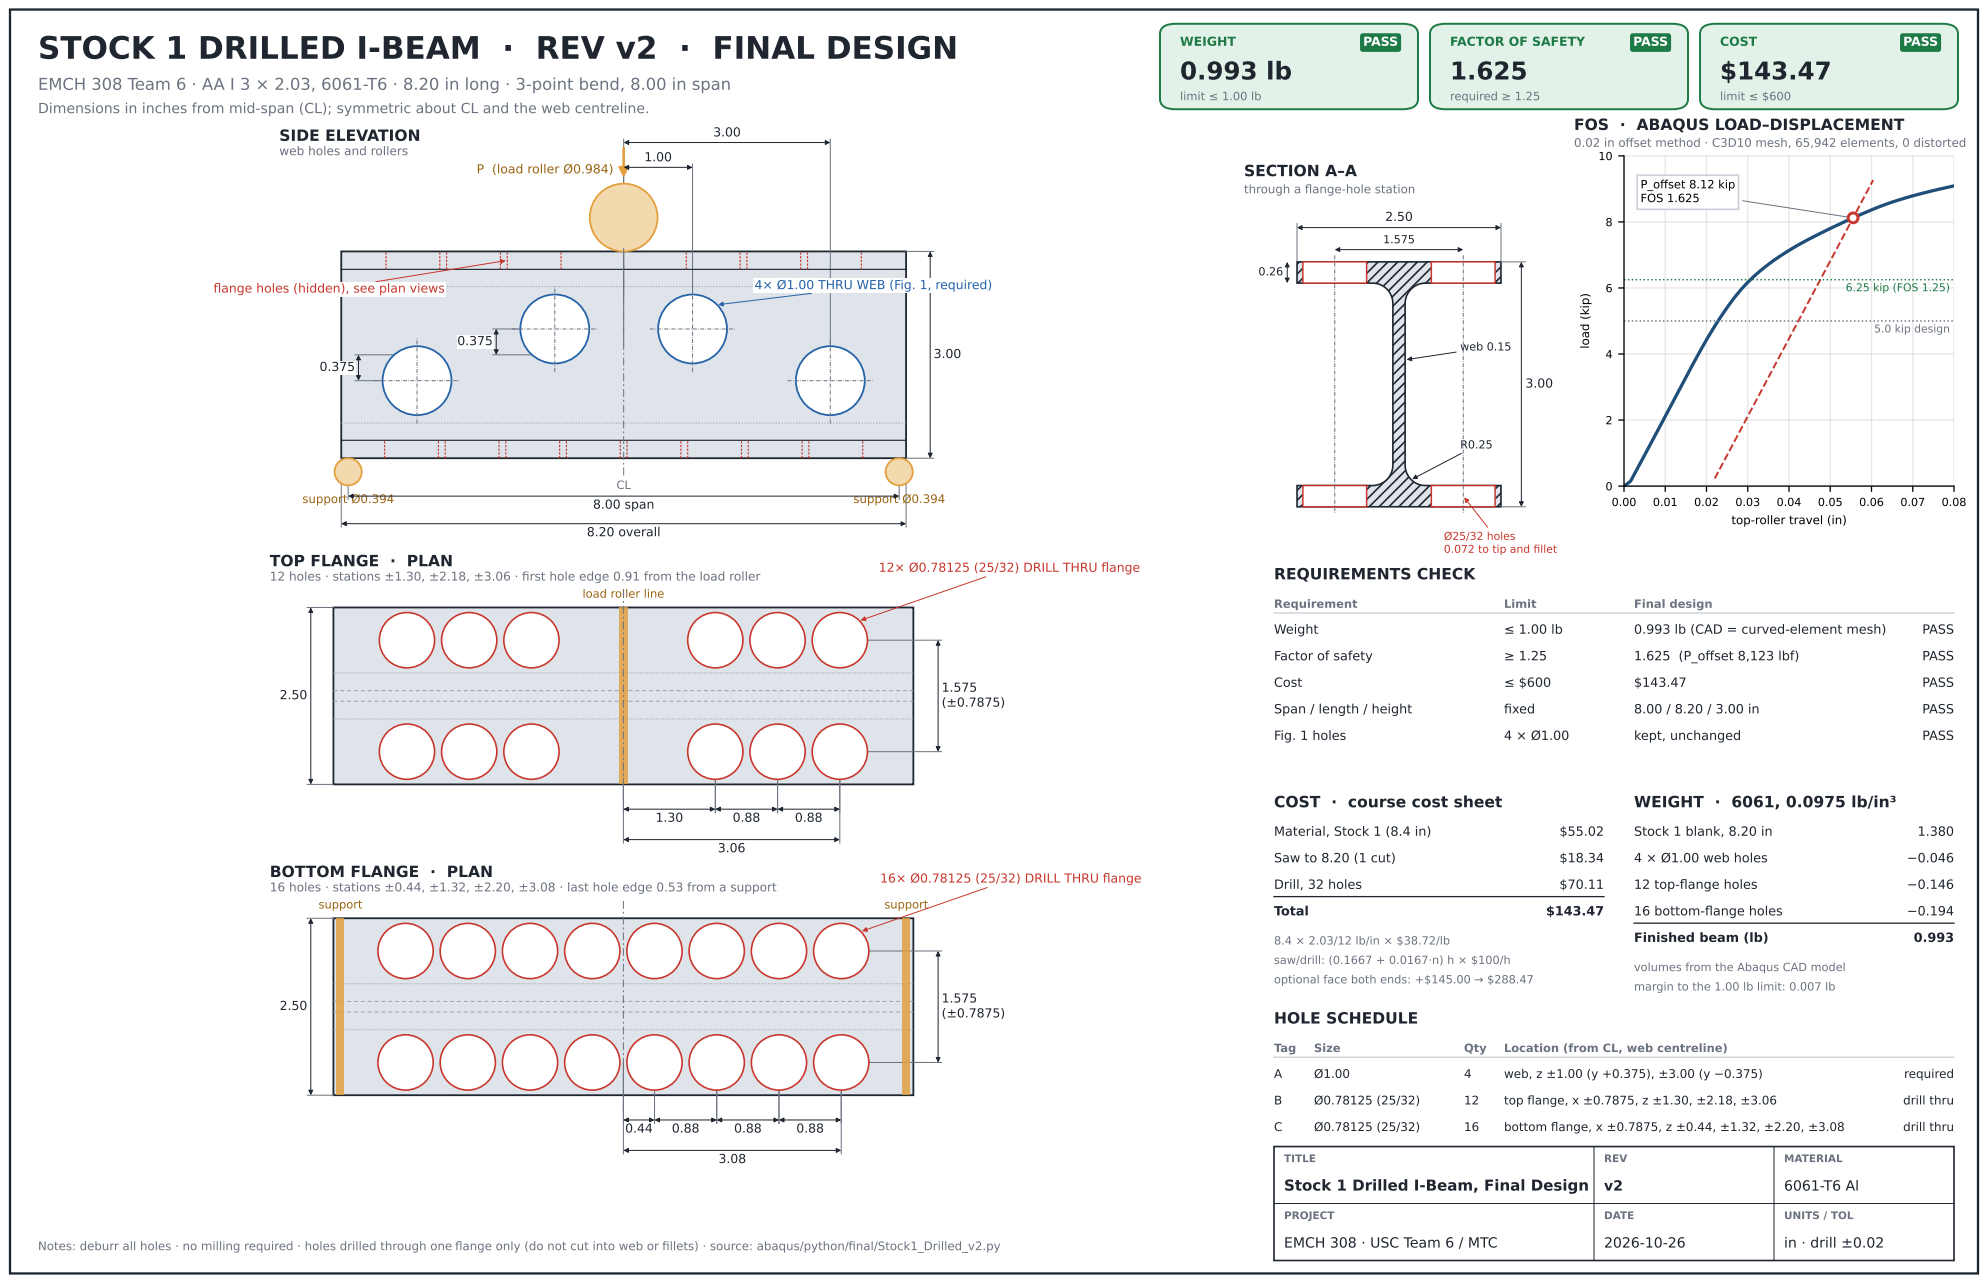
[picture p31: page 1]
P (load roller Ø0.984); support Ø0.394; 8.20 overall; 8.00 span; flange holes (hidden), see plan views; 4× Ø1.00 THRU WEB (Fig. 1, required); support; BOTTOM FLANGE · PLAN; 16× Ø0.78125 (25/32) DRILL THRU flange 16 holes · stations ±0.44, ±1.32, ±2.20, ±3.08 · last hole edge 0.53 from a support; web 0.15; load (kip); P_offset 8.12 kip; FOS; WEIGHT 0.993 lb; PASS; limit ≤ 1.00 lb; required ≥ 1.25; COST $143.47; limit ≤ $600; REQUIREMENTS CHECK; Requirement; Limit; Final design; Weight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

STOCK 1 DRILLED I-BEAM · REV v2 · FINAL DESIGN

FACTOR OF SAFETY

EMCH 308 Team 6 · AA I 3 × 2.03, 6061-T6 · 8.20 in long · 3-point bend, 8.00 in span

Dimensions in inches from mid-span (CL); symmetric about CL and the web centreline.

FOS · ABAQUS LOAD–DISPLACEMENT
0.02 in offset method · C3D10 mesh, 65,942 elements, 0 distorted

web holes and rollers

through a flange-hole station

6.25 | kip (FOS 1.25)

5.0 kip | design

top-roller travel (in)

Ø25/32 holes
0.072 to tip and fillet

12× Ø0.78125 (25/32) DRILL THRU flange TOP FLANGE · PLAN
12 holes · stations ±1.30, ±2.18, ±3.06 · first hole edge 0.91 from the load roller

load roller line

COST · course cost sheet

WEIGHT · 6061, 0.0975 lb/in³

saw/drill: (0.1667 + 0.0167·n) h × $100/h
optional face both ends: +$145.00 → $288.47

volumes from the Abaqus CAD model
margin to the 1.00 lb limit: 0.007 lb

TITLE
Stock 1 Drilled I-Beam, Final Design

EMCH 308 · USC Team 6 / MTC
