RyanBilock/EMCH-308_Group-6_Final-Project/cad/USC06_MTC06_IBeam_RevB_Drawing.pdf

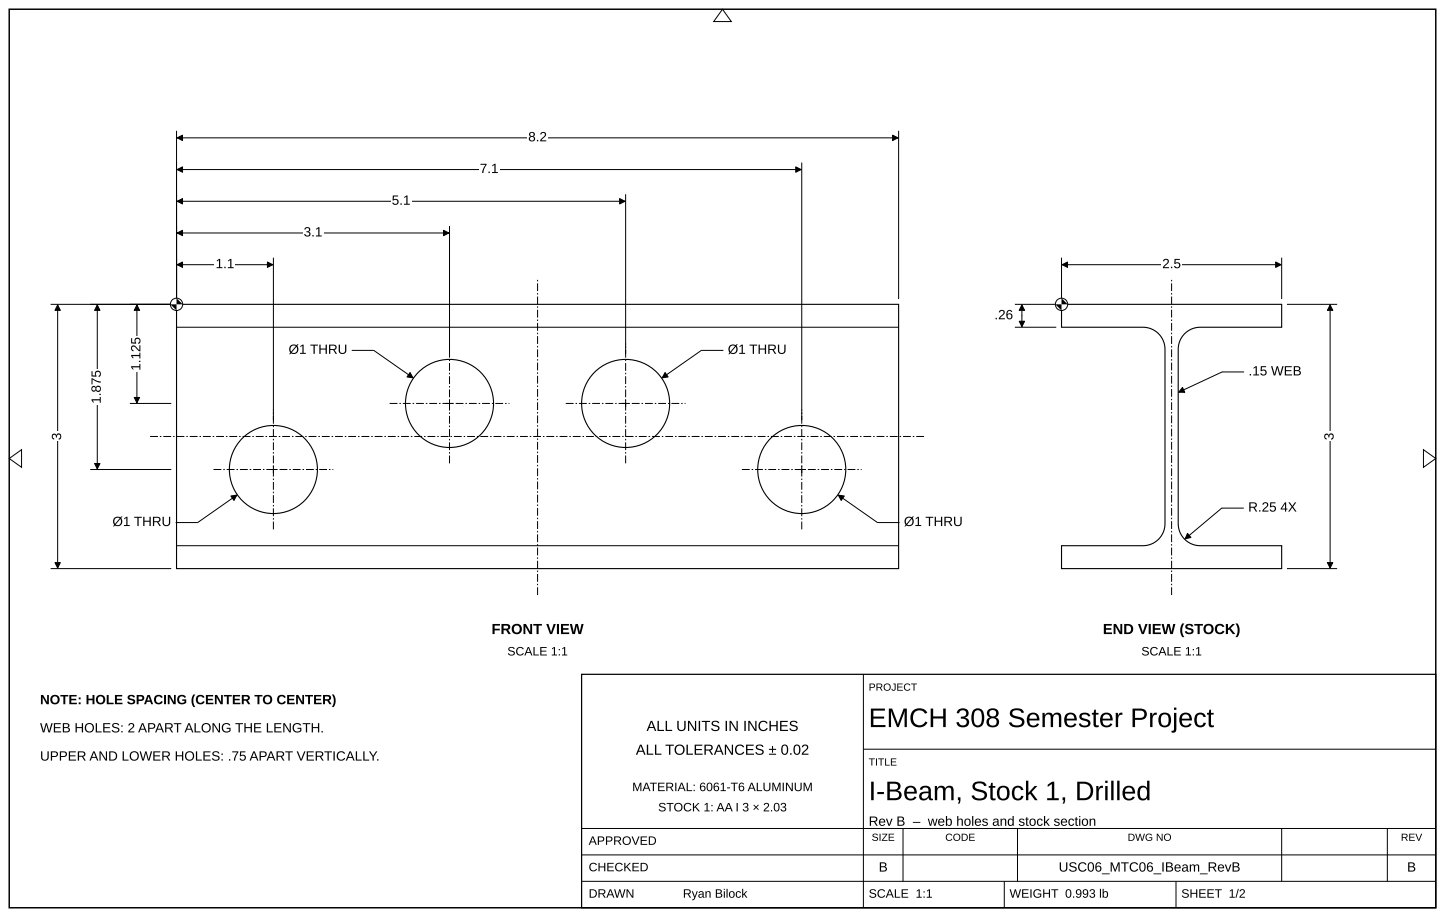
[picture p32: page 1]
Ø1 THRU; FRONT VIEW; SCALE 1:1; .15 WEB; MATERIAL: 6061-T6 ALUMINUM; STOCK 1: AA I 3 × 2.03; APPROVED; CHECKED; DRAWN; Ryan Bilock; SIZE; CODE; DWG NO; USC06_MTC06_IBeam_RevB; REV; WEIGHT 0.993 lb; SHEET 1/2

END VIEW (STOCK)

PROJECT
EMCH 308 Semester Project

NOTE: HOLE SPACING (CENTER TO CENTER)

ALL UNITS IN INCHES
ALL TOLERANCES ± 0.02

WEB HOLES: 2 APART ALONG THE LENGTH.

UPPER AND LOWER HOLES: .75 APART VERTICALLY.

TITLE
I-Beam, Stock 1, Drilled

Rev B – web holes and stock section

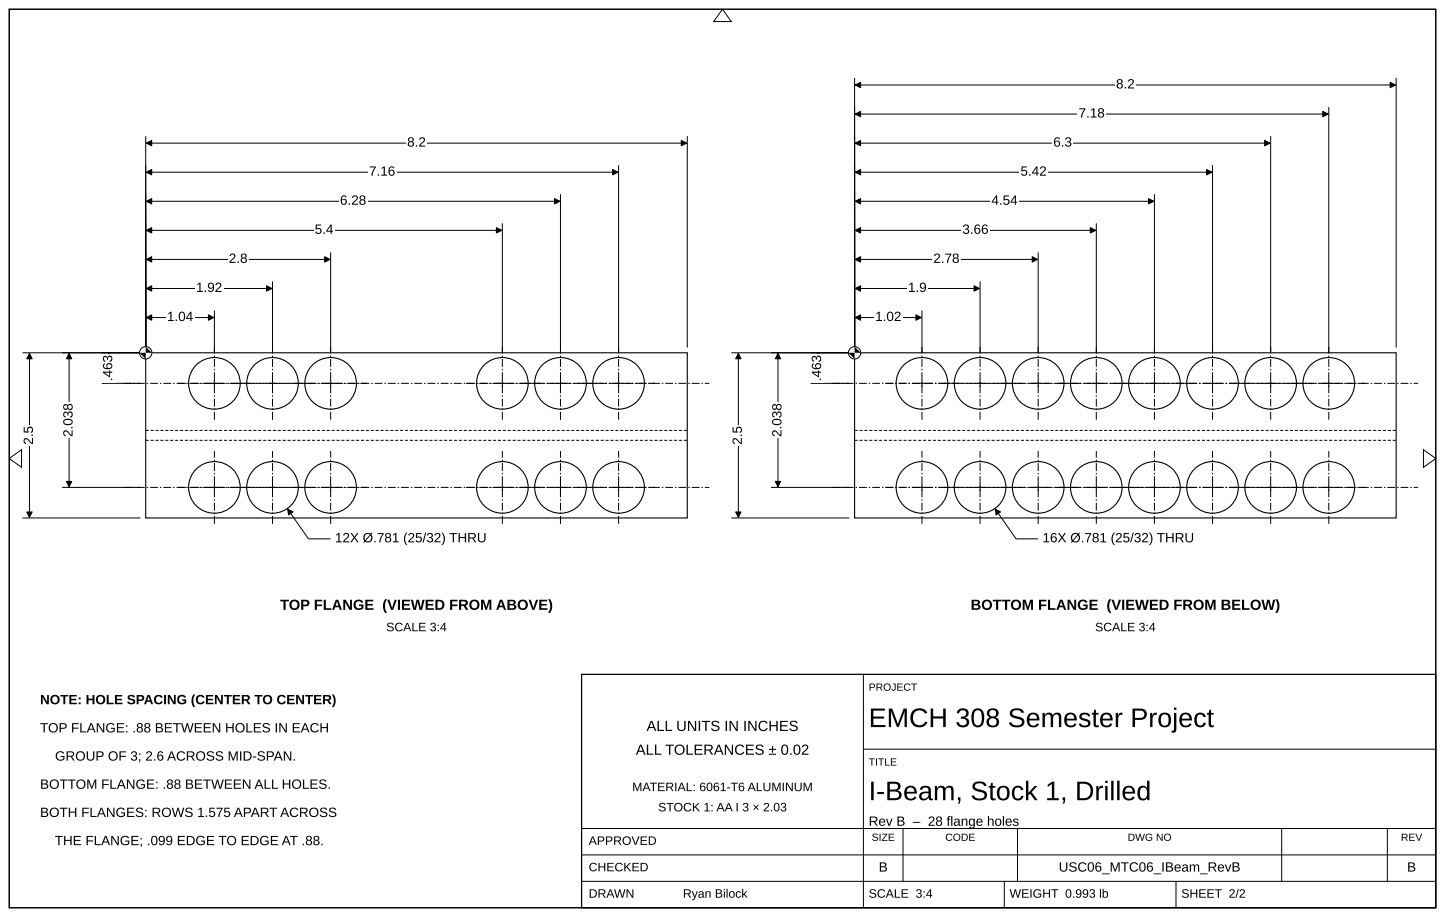
[picture p33: page 2]
12X Ø.781 (25/32) THRU; SCALE 3:4; 16X Ø.781 (25/32) THRU; MATERIAL: 6061-T6 ALUMINUM; STOCK 1: AA I 3 × 2.03; APPROVED; CHECKED; DRAWN; Ryan Bilock; SIZE; CODE; DWG NO; USC06_MTC06_IBeam_RevB; REV; WEIGHT 0.993 lb; SHEET 2/2

TOP FLANGE (VIEWED FROM ABOVE)

BOTTOM FLANGE (VIEWED FROM BELOW)

PROJECT
EMCH 308 Semester Project

NOTE: HOLE SPACING (CENTER TO CENTER)

ALL UNITS IN INCHES
ALL TOLERANCES ± 0.02

TOP FLANGE: .88 BETWEEN HOLES IN EACH

GROUP OF 3; 2.6 ACROSS MID-SPAN.

TITLE
I-Beam, Stock 1, Drilled

BOTTOM FLANGE: .88 BETWEEN ALL HOLES.

BOTH FLANGES: ROWS 1.575 APART ACROSS

Rev B – 28 flange holes

THE FLANGE; .099 EDGE TO EDGE AT .88.
