RyanBilock/EMCH-308_Group-6_Final-Project/(commit log)

2026-10-02 Add team roster, .gitignore, and project folders
    - README: add Team 6 roster and instructors; update folder table to match repo layout
    - Add .gitignore for Abaqus temporary/job files, Python cache, and OS files
    - Add cad/, results/, report/ folders with .gitkeep placeholders
    Claude-Session: https://claude.ai/code/session_01WDNkRDTA81Upp2xfyEWi4d
2026-10-26 Add Abaqus models, scripts, FEA results, and concept drawings
    - abaqus/: ProjectBeam, Baseline_Stock1, Stock1_Drilled models; Stock1_Notched job (.cae/.jnl/.inp)
    - abaqus/python/: current model-build and FoS scripts
    - results/: Stock1_Notched (FoS 1.64, 0.957 lb) and Stock 3 8.2 in (FoS 3.55) load-displacement plots, CSVs, FoS tables
    - cad/concept_drawings/: material-removal and cost-plan drawings
    - README: file map, how to run the scripts, design status
    - .gitignore: local archive/, script logs, and the 354 MB Stock1_Notched.odb
    Claude-Session: https://claude.ai/code/session_01YQnAUrFUrgThWnekDhwfxV
2026-10-26 Add Stock 1 drilled job and FoS scripts
    - abaqus/python/Stock1_Drilled_Job_v1.py: pre-submit checks, job saved and run in abaqus/Stock1_Drilled/
    - abaqus/python/FOS_Stock1_Drilled_v1.py: offset-method FoS, mesh weight, peak Mises at 5,000 lbf, CSV/TXT/PNG to results/Stock1_Drilled/
    - README: file map and design status updated
    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
2026-10-26 Add Stock 1 drilled v2 redesign and FoS v2; add v1 results
    - Stock1_Drilled_v2.py: no extra web holes, flange holes clear of the rollers, no milling, job in its own folder, time marks off
    - FOS_Stock1_Drilled_v2.py: exact C3D10 weight, first-yield location
    - results/Stock1_Drilled: v1 run (FoS 1.246)
    - cad/concept_drawings/Hole_Layout_Stock1_Drilled_v2.png
    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
2026-10-26 Final design: Stock 1 drilled v2 results, cost sheet, updated README
    - results/Stock1_Drilled_v2: Abaqus FoS 1.625 (P_offset 8,123 lbf), 0.993 lb
    - abaqus/Stock1_Drilled_v2(.cae/.jnl) and job folder (.cae/.jnl/.inp); drilled v1 job folder
    - cost/ProjectCostSheet_Stock1_Drilled_v2.xlsx: course sheet filled in, total $143.47
    - Hole layout drawing and v1/v2 load-displacement plots updated
    - README: final design, requirement check, cost breakdown, design history
    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
2026-10-26 Reorganize repository: base models, final design, iterations
    - abaqus/: base_models/, final_design/ (+ job/), iterations/ (Stock1_Notched, Stock1_Drilled_v1)
    - abaqus/python/: final/, tools/, iterations/, fix_history/
    - results/: final_design/, iterations/, new Design_Comparison.png overlay of all four designs
    - cad/: drawings/ (final hole layout) vs concept_drawings/ (superseded)
    - README: final design first, repository layout tree, run steps, design history with plot
    - .gitignore: ignore all .odb files; drop stray .gitkeep
    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
2026-10-26 Add Export_STEP_v1.py: export the final Beam part to cad/USC06_MTC06_IBeam_RevA.step
    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
2026-10-26 Simplify Rev B drawing to match MTC's example (ordinate dims from X/Y datum, hole notes); keep GD&T version in cad/drawings
    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
2026-10-26 Rev B drawing: add hole-spacing notes
    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
2026-10-26 Rev B drawing: remove hole-spacing notes
    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
2026-10-26 Add Rev B STEP (unit fixed to INCH) and Creo part; Export_STEP_v3.py relabels STEP units as inches
    Abaqus wrote the STEP with a MILLIMETRE unit while the model is in inches, so it imported 25.4x too small.
    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
2026-11-03 Add Rev C concept v2 proposal: drawing, scripts, cost sheet
    - cad/concept_drawings: Proposal_RevC_Stock1_v2 (.png, .pdf)
    - cad/drawings/source: make_RevC_concept_v1.py, make_RevC_concept_v2.py
    (v2 now writes straight to cad/concept_drawings)
    - cost: ProjectCostSheet_RevC_Stock1_v2.xlsx ($131.78)
    - README: Rev C proposal section, layout tree, design history row
    Rev B stays the final design until Rev C is checked in Abaqus.
    Claude-Session: https://claude.ai/code/session_014AVQbbnMuJ5ZJiSA3v4UuR
2026-11-03 Make Rev C the final design; move Rev B to old designs
    - Final_Design/ now holds Rev C (concept sheet, cost sheet, script;
    Abaqus and CAD placeholders until the Rev C model is run)
    - Rev B package moved to Old_Designs/RevB_Stock1_Drilled_v2/
    - Rev B originals out of the "final" folders:
    abaqus/final_design -> abaqus/iterations/Stock1_Drilled_v2_RevB
    results/final_design -> results/iterations/Stock1_Drilled_v2_RevB
    abaqus/python/final/* -> abaqus/python/iterations/
    cad RevB STEP, drawings, creo -> cad/old_designs/RevB/
    Rev B cost sheet -> cost/old_designs/
    - .gitignore: LFS .odb exceptions follow the Rev B .odb to its new paths
    - READMEs updated for the new layout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
2026-11-03 Add Rev C Abaqus scripts: build/finest-mesh job and FoS/weight accuracy
    - abaqus/python/final/Stock1_RevC_v1.py: builds Rev C (8.40 in, dia 1.03
    web holes, 0.65 in flange notches with R0.25 corners, full-width pads at
    the three rollers), finds the finest C3D10 mesh under the 250,000-node
    licence limit, 1 % max increments, saves into abaqus/final_design/ and
    submits the job. MESH_LEVEL = 'CHECK' builds a Rev B-density mesh-check job.
    - abaqus/python/final/FOS_Stock1_RevC_v1.py: offset-method FoS, exact
    curved-element weight vs CAD vs hand calc, fit-window sensitivity, curve
    resolution, mesh convergence, departure from linear and permanent set at
    6,250 lbf; writes results/final_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
2026-11-03 Add Rev C design sheet and 3-sheet manufacturing drawing
    - cad/USC06_MTC06_IBeam_RevC_Drawing.pdf (+ sheet PNGs): front/end view,
    top flange, bottom flange, all 1:1 with baseline dims from the datum,
    R.25 corners, relief drills, notes, Rev C title block
    - cad/drawings/Design_Sheet_Stock1_RevC_v1 (.png/.pdf): one-page sheet with
    views, sections, Abaqus FoS curve, requirement/cost/weight tables, schedule
    - scripts in cad/drawings/source; copies in Final_Design; READMEs updated
    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
2026-11-03 Add Rev C warning-fix rerun, STEP export and FOS v3 scripts
    - fix_Stock1_RevC_v1.py: opens Stock1_RevC_v1.cae (same mesh), gives the
    support-roller contacts the same 0.001 in strain-free adjustment as the
    top roller and starts at a 0.1 % increment, then submits Stock1_RevC_v2
    (removes the 7 warnings from v1's rejected increment-2 attempt)
    - Export_STEP_v4.py: checks the Rev C beam and writes
    cad/USC06_MTC06_IBeam_RevC.step with the unit relabelled to INCH
    - FOS_Stock1_RevC_v3.py: reads the v2 job when present, counts solver
    warnings/errors, compares v2 with v1
    - Copies in Final_Design/Scripts; READMEs updated
    Claude-Session: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
2026-11-03 Organize Rev C: STEP file, model/job files, Final_Design complete, Organize_Project_v5
    - cad/USC06_MTC06_IBeam_RevC.step (inches; checked in OpenCascade: one valid
    solid, 8.40 x 2.50 x 3.00 in, 9.3252 in^3, 4 x dia 1.03 holes, 8 x R0.25
    notch corners, flange widths correct at every station)
    - abaqus/final_design: Stock1_RevC_v1.cae/.jnl and job/ (.cae, .inp, .jnl,
    geometry); the 519 MB .odb stays on the project drive (LFS quota)
    - Final_Design/Abaqus and Final_Design/CAD filled in; placeholders removed
    - Organize_Project_v5.py: brings a local copy into this layout (backup,
    git reset to origin/main, moves local-only leftovers to archive/)
    - READMEs updated (STEP done, v2 rerun status,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
2026-11-03 Replace Organize_Project_v5.py with a PowerShell version
    The team computer has no Python, Abaqus or git on its PATH, so the organizer
    is now Organize_Project_v5.ps1 (Windows PowerShell 5.1+): explicit move/copy
    lists worked out against GitHub main, local-only leftovers to archive/,
    nothing deleted unless an identical copy is already at the destination.
    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
